antmicro/kintex-410t-devboard/assets/wireframe/wireframe_dimensions.png

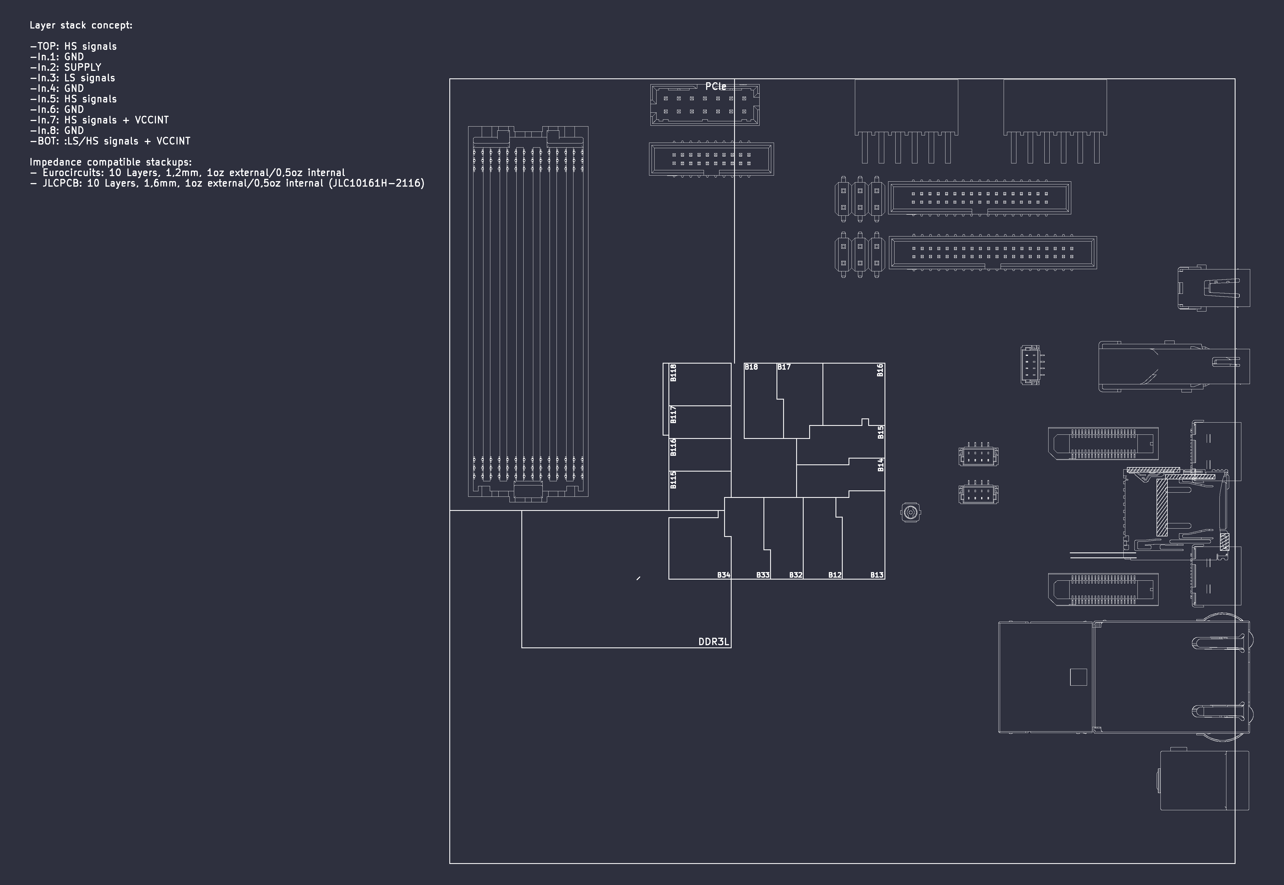
assets/wireframe/wireframe_dimensions.png
