antmicro/kintex-410t-devboard/assets/wireframe/wireframe_dimensions_bottom.png

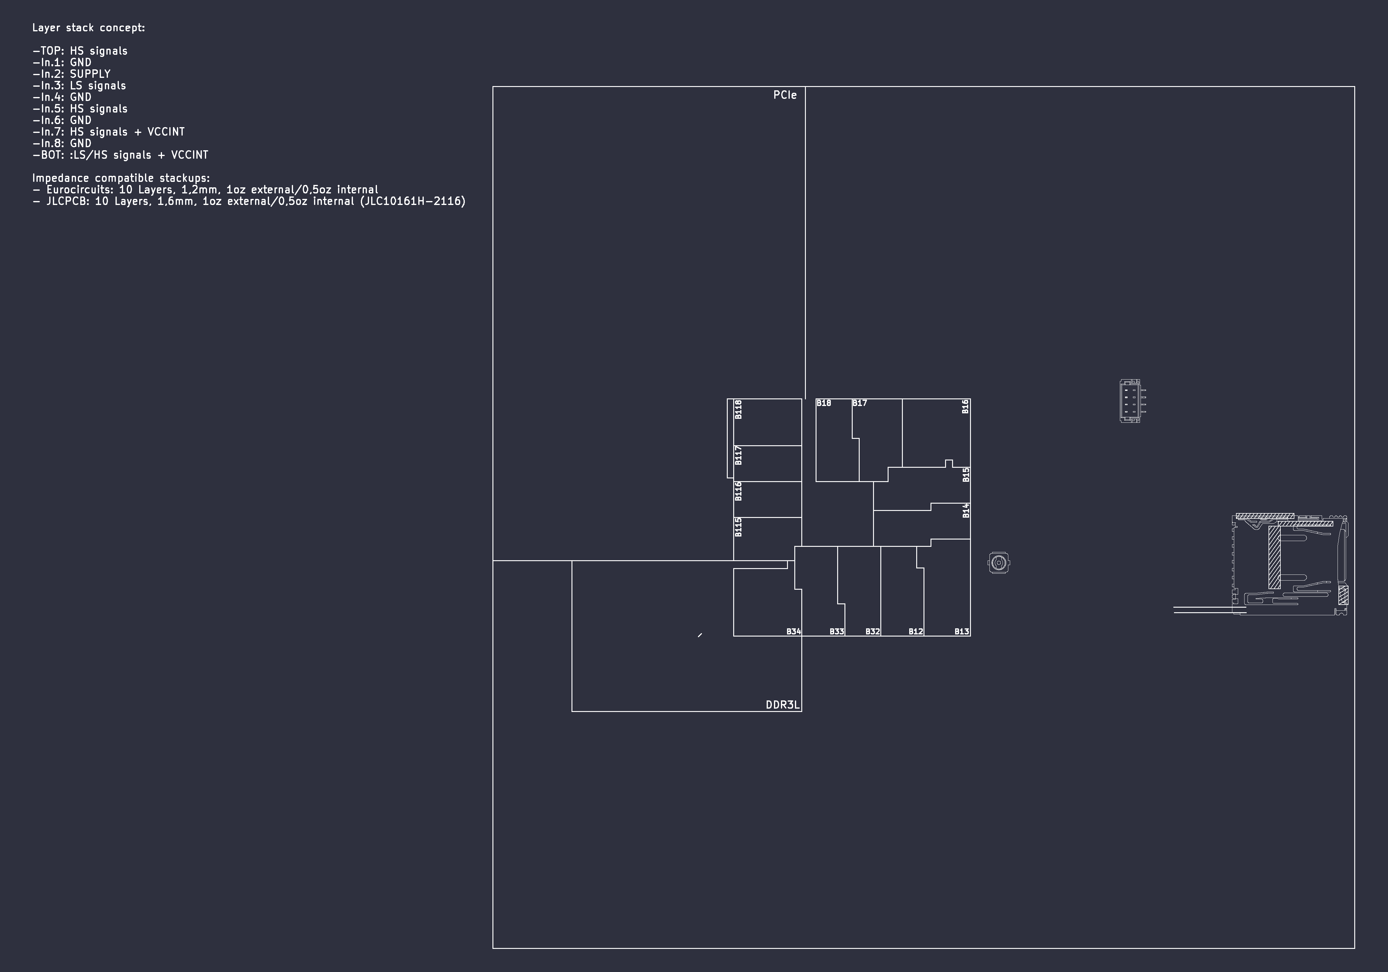
assets/wireframe/wireframe_dimensions_bottom.png
