antmicro/kintex-410t-devboard/assets/wireframe/wireframe_dimensions_top.png

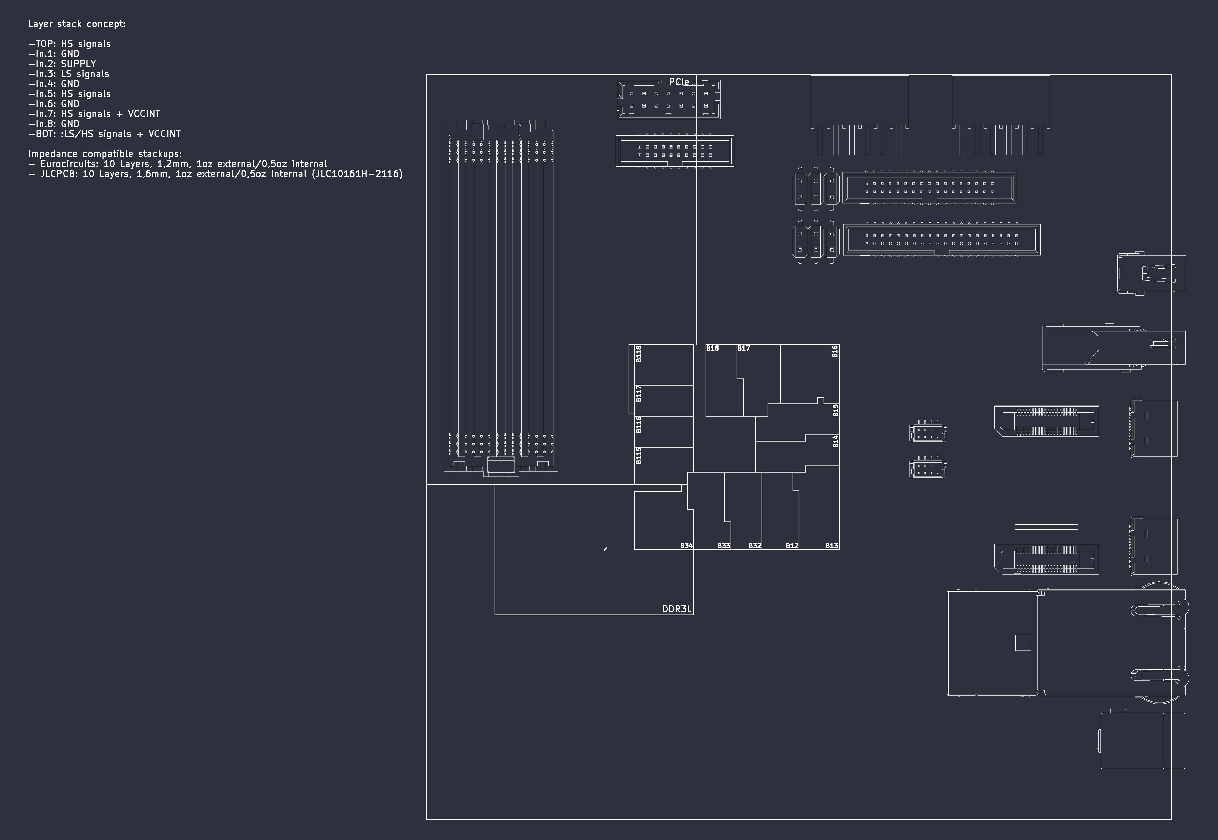
assets/wireframe/wireframe_dimensions_top.png
