antmicro/kintex-410t-devboard/(threads)

Thread 3 (2025-01-27):

Impedance question

ap-gval, 2025-01-27:
Good morning,

I have a question concerning the way the 100R impedance of HDMI is computed.

Example: pair HDMI_CONN_CLK_N, HDMI_CONN_CLK_P

Kicad project:  kintex-410t-devboard

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

coupled microstrip line

W = 0.153mm

S = 0.2mm

T = 0.035mm

H = 0.12mm

epsilon 3.9

I have got Z_odd = 60.8R so Z_diff = 2*Z_odd = 121.6R.

I have seen large differences between transmission line calculators I can't explain. Below calculations from calculators I think are correct.

QucsStudio (rename uSimmics)

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

Digikey

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

Could I have a feedback?

Thanks for your time. Maybe it will help improve your design on your side.

Guillaume

pkatarzynski, 2025-01-31:
Hi ap-gval

In your calculations on DigiKey website you input width of trace and height of dielectric as mils not mm.
If you change that unit to mm you'll see that it the outcome is 103 Ohm which matches the targed impedance (assuming +/-  5% margin)
We have cross-checked this with Saturn PCB Toolkit and the results are comparable.

We are not sure why uSimmics provides a different outcome. Is there a calculation formula documented for the uSimmcs? If so then it would be good to compare it with Digi-Key for instance (the Zd formula is visible in Digi-Key screenshot).

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

ap-gval, 2025-01-31:
Hello,

thank you for your answer. You right for my mistake.
At the moment I think the formula for coupled microstrip of Digikey, Saturn PCB (IPC 2141) is over simplified.
Kicad, Qucs, use one more complex (paper H. A. Atwater, “Simplified Design Equations for Microstrip Line Parameters”, can't find it again).

One remark for HDMI impedance can vary between 100R +/-15%.
I would like to check with a EM solver like openems, sonnet or freefem++.

Guillaume Valancogne

Closed 2025-01-31.
