antmicro/kintex-410t-devboard/K410T-devboard.kicad_pcb

## KiCad design K410T-devboard.kicad_pcb (2023-01-03)

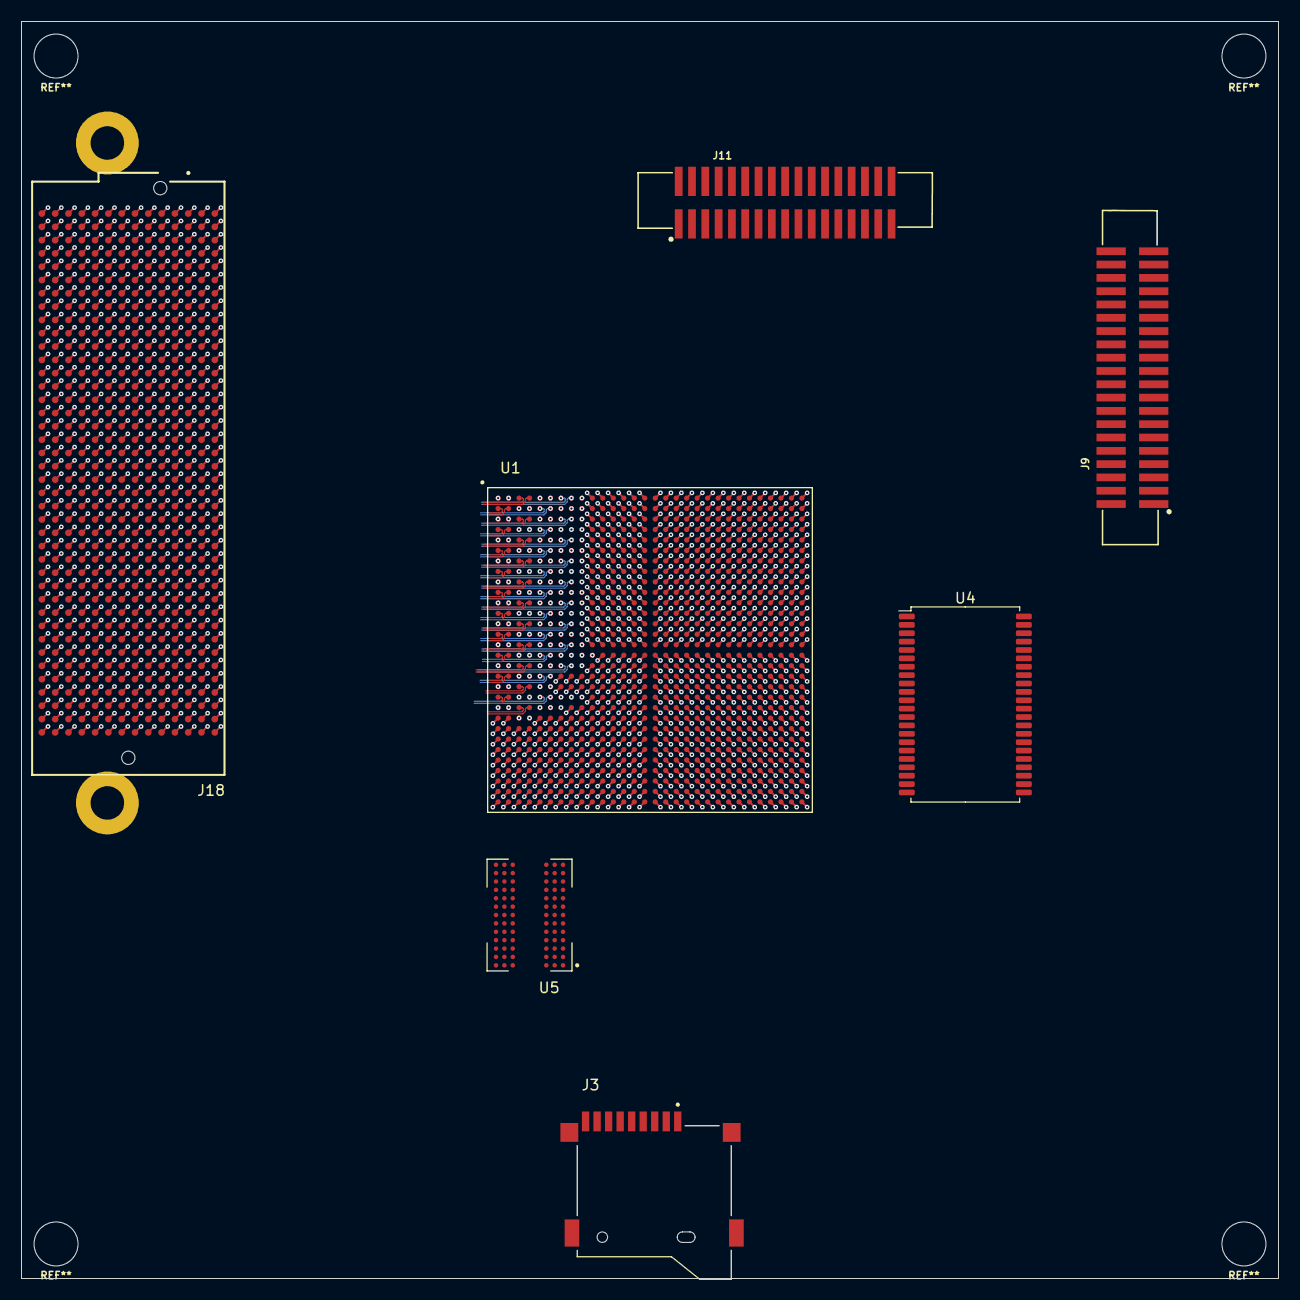
[picture p8: board K410T-devboard.kicad_pcb from above]

Board: 10 copper layers, 120.0 x 120.0 mm, 7 parts (0 on the bottom side), 213 nets.

Parts:
J3: 693071020811; WE_693071020811
J9: 62704020621; 627x4020621
J11: 62703420621; 627x3420621
J18: ASP-184329-01_mounting_holes_FMCPinout; ASP-184329-01_mounting_holes
U1: XC7K410T-2FFG900I; xc7k410t-2ffg900I
U4: AS6C8008-55ZIN; TSOP-II-44_10.16x18.41mm_P0.8mm
U5: MT41K512M8DA; Micron_FBGA-78

Connections:
3V3_SYS: J18.C39 (3P3V), J18.D36 (3P3V), J18.D38 (3P3V), J18.D40 (3P3V)
12P0V: J18.C35 (12P0V), J18.C37 (12P0V)
+0V675_VREF: U5.E1 (VREFDQ), U5.J8 (VREFCA)
+0V675_VTT: U1.AD7 (IO_L6N_T0_VREF_34), U1.AG8 (IO_L19N_T3_VREF_34)
+1V0: U1.M11 (VCCINT), U1.M13 (VCCINT), U1.M15 (VCCINT), U1.M17 (VCCINT), U1.N10 (VCCINT), U1.N12 (VCCINT), U1.N14 (VCCINT), U1.N16 (VCCBRAM), U1.N18 (VCCINT), U1.P11 (VCCINT), U1.P17 (VCCINT), U1.R10 (VCCINT), U1.R12 (VCCINT), U1.R16 (VCCBRAM), U1.R18 (VCCINT), U1.T11 (VCCINT), U1.T17 (VCCINT), U1.U10 (VCCINT), U1.U12 (VCCINT), U1.U16 (VCCBRAM), U1.U18 (VCCINT), U1.V17 (VCCINT), U1.W16 (VCCBRAM), U1.W18 (VCCINT)
+1V2_MGTAVCC: U1.B7 (MGTAVCC), U1.D7 (MGTAVCC), U1.F7 (MGTAVCC), U1.H7 (MGTAVCC), U1.K7 (MGTAVCC), U1.M7 (MGTAVCC), U1.P7 (MGTAVCC)
+1V2_MGTAVTT: U1.B3 (MGTAVTT), U1.C5 (MGTAVTT), U1.D3 (MGTAVTT), U1.E5 (MGTAVTT), U1.F3 (MGTAVTT), U1.G5 (MGTAVTT), U1.H3 (MGTAVTT), U1.J5 (MGTAVTT), U1.K3 (MGTAVTT), U1.L5 (MGTAVTT), U1.M3 (MGTAVTT), U1.N5 (MGTAVTT), U1.P3 (MGTAVTT), U1.R5 (MGTAVTT), U1.T3 (MGTAVTT), U1.U5 (MGTAVTT), U1.V3 (MGTAVTT), U1.W5 (MGTAVTT), U1.W7 (MGTAVTTRCAL_115)
+1V8: U1.AA9 (VCCO_33), U1.AA19 (VCCO_32), U1.AB16 (VCCO_32), U1.AC13 (VCCO_33), U1.AD10 (VCCO_33), U1.AE17 (VCCO_32), U1.AF14 (VCCO_32), U1.AG11 (VCCO_33), U1.AH18 (VCCO_32), U1.AJ15 (VCCO_32), U1.AK12 (VCCO_33), U1.P13 (VCCAUX), U1.T7 (MGTVCCAUX), U1.T13 (VCCAUX), U1.V7 (MGTVCCAUX), U1.V11 (VCCAUX_IO_G0), U1.V13 (VCCAUX), U1.V15 (VCCAUX), U1.W10 (VCCAUX_IO_G0), U1.W12 (VCCAUX_IO_G0), U1.W14 (VCCAUX), U1.Y12 (VCCO_33)
+1V35: U1.AC3 (VCCO_34), U1.AE7 (VCCO_34), U1.AF4 (VCCO_34), U1.AG1 (VCCO_34), U1.AH8 (VCCO_34), U1.AJ5 (VCCO_34), U1.AK2 (VCCO_34), U5.A2 (VDD), U5.A9 (VDD), U5.B9 (VDDQ), U5.C1 (VDDQ), U5.D7 (VDD), U5.E2 (VDDQ), U5.E9 (VDDQ), U5.G2 (VDD), U5.G8 (VDD), U5.K1 (VDD), U5.K9 (VDD), U5.M1 (VDD), U5.M9 (VDD)
+3V3: J3.4 (VDD), J9.22, J11.22, U1.AA29 (VCCO_13), U1.AB6 (VCCO_0), U1.AB26 (VCCO_13), U1.AC23 (VCCO_12), U1.AD20 (VCCO_12), U1.AD30 (VCCO_13), U1.AE27 (VCCO_13), U1.AF24 (VCCO_12), U1.AG21 (VCCO_12), U1.AH28 (VCCO_13), U1.AJ25 (VCCO_13), U1.AK22 (VCCO_12), U1.P30 (VCCO_14), U1.R27 (VCCO_14), U1.T9 (VCCO_0), U1.T24 (VCCO_14), U1.U21 (VCCO_14), U1.V28 (VCCO_14), U1.W25 (VCCO_14), U1.Y22 (VCCO_12), U4.11 (VCC), U4.33 (VCC)
/DRAM + SRAM/DDR.A0: U1.AE4 (IO_L10P_T1_34), U5.K3 (A0)
/DRAM + SRAM/DDR.A1: U1.AG3 (IO_L9N_T1_DQS_34), U5.L7 (A1)
/DRAM + SRAM/DDR.A2: U1.AG4 (IO_L9P_T1_DQS_34), U5.L3 (A2)
/DRAM + SRAM/DDR.A3: U1.AF1 (IO_L8N_T1_34), U5.K2 (A3)
/DRAM + SRAM/DDR.A4: U1.AE1 (IO_L8P_T1_34), U5.L8 (A4)
/DRAM + SRAM/DDR.A5: U1.AF2 (IO_L7N_T1_34), U5.L2 (A5)
/DRAM + SRAM/DDR.A6: U1.AF3 (IO_L7P_T1_34), U5.M8 (A6)
/DRAM + SRAM/DDR.A7: U1.AC7 (IO_L6P_T0_34), U5.M2 (A7)
/DRAM + SRAM/DDR.A8: U1.AE6 (IO_L5N_T0_34), U5.N8 (A8)
/DRAM + SRAM/DDR.A9: U1.AD6 (IO_L5P_T0_34), U5.M3 (A9)
/DRAM + SRAM/DDR.A10: U1.AC4 (IO_L4N_T0_34), U5.H7 (A10/AP)
/DRAM + SRAM/DDR.A11: U1.AC5 (IO_L4P_T0_34), U5.M7 (A11)
/DRAM + SRAM/DDR.A12: U1.AC1 (IO_L2N_T0_34), U5.K7 (A12/BC#)
/DRAM + SRAM/DDR.A13: U1.AC2 (IO_L2P_T0_34), U5.N3 (A13)
/DRAM + SRAM/DDR.A14: U1.AD3 (IO_L1N_T0_34), U5.N7 (A14)
/DRAM + SRAM/DDR.A15: U1.AD4 (IO_L1P_T0_34), U5.J7 (A15)
/DRAM + SRAM/DDR.BA0: U1.AF5 (IO_L11N_T1_SRCC_34), U5.J2 (BA0)
/DRAM + SRAM/DDR.BA1: U1.AE5 (IO_L11P_T1_SRCC_34), U5.K8 (BA1)
/DRAM + SRAM/DDR.BA2: U1.AE3 (IO_L10N_T1_34), U5.J3 (BA2)
/DRAM + SRAM/DDR.CKE: U1.AH2 (IO_L16P_T2_34), U5.G9 (CKE)
/DRAM + SRAM/DDR.CK_N: U1.AD1 (IO_L3N_T0_DQS_34), U5.G7 (CK#)
/DRAM + SRAM/DDR.CK_P: U1.AD2 (IO_L3P_T0_DQS_34), U5.F7 (CK)
/DRAM + SRAM/DDR.DM: U1.AF8 (IO_L19P_T3_34), U5.B7 (DM/TDQS)
/DRAM + SRAM/DDR.DQ0: U1.AK5 (IO_L24P_T3_34), U5.B3 (DQ0)
/DRAM + SRAM/DDR.DQ1: U1.AK8 (IO_L23N_T3_34), U5.C7 (DQ1)
/DRAM + SRAM/DDR.DQ2: U1.AK6 (IO_L22N_T3_34), U5.C2 (DQ2)
/DRAM + SRAM/DDR.DQ3: U1.AJ6 (IO_L22P_T3_34), U5.C8 (DQ3)
/DRAM + SRAM/DDR.DQ4: U1.AG7 (IO_L20N_T3_34), U5.E3 (NF/DQ4)
/DRAM + SRAM/DDR.DQ5: U1.AJ8 (IO_L23P_T3_34), U5.E8 (NF/DQ5)
/DRAM + SRAM/DDR.DQ6: U1.AK4 (IO_L24N_T3_34), U5.D2 (NF/DQ6)
/DRAM + SRAM/DDR.DQ7: U1.AF7 (IO_L20P_T3_34), U5.E7 (NF/DQ7)
/DRAM + SRAM/DDR.DQS_N: U1.AJ7 (IO_L21N_T3_DQS_34), U5.D3 (DQS#)
/DRAM + SRAM/DDR.DQS_P: U1.AH7 (IO_L21P_T3_DQS_34), U5.C3 (DQS)
/DRAM + SRAM/DDR.ODT: U1.AJ2 (IO_L16N_T2_34), U5.G1 (ODT)
/DRAM + SRAM/DDR.~CAS: U1.AF6 (IO_L12P_T1_MRCC_34), U5.G3 (CAS#)
/DRAM + SRAM/DDR.~CS: U1.AH1 (IO_L15N_T2_DQS_34), U5.H2 (CS#)
/DRAM + SRAM/DDR.~RAS: U1.AG5 (IO_L12N_T1_MRCC_34), U5.F3 (RAS#)
/DRAM + SRAM/DDR.~RESET: U1.AH4 (IO_L13P_T2_MRCC_34), U5.N2 (RESET#)
/DRAM + SRAM/DDR.~WE: U1.AG2 (IO_L15P_T2_DQS_34), U5.H3 (WE#)
/DRAM + SRAM/SRAM.A0: U1.U28 (IO_L13N_T2_MRCC_14), U4.5 (A0)
/DRAM + SRAM/SRAM.A1: U1.V29 (IO_L17P_T2_A14_D30_14), U4.4 (A1)
/DRAM + SRAM/SRAM.A2: U1.T25 (IO_L14P_T2_SRCC_14), U4.3 (A2)
/DRAM + SRAM/SRAM.A3: U1.T26 (IO_L12P_T1_MRCC_14), U4.2 (A3)
/DRAM + SRAM/SRAM.A4: U1.V20 (IO_L19N_T3_A09_D25_VREF_14), U4.1 (A4)
/DRAM + SRAM/SRAM.A5: U1.P27 (IO_L8P_T1_D11_14), U4.44 (A5)
/DRAM + SRAM/SRAM.A6: U1.P28 (IO_L8N_T1_D12_14), U4.43 (A6)
/DRAM + SRAM/SRAM.A7: U1.V24 (IO_L23N_T3_A02_D18_14), U4.42 (A7)
/DRAM + SRAM/SRAM.A8: U1.R26 (IO_L10N_T1_D15_14), U4.39 (A8)
/DRAM + SRAM/SRAM.A9: U1.R30 (IO_L9P_T1_DQS_14), U4.28 (A9)
/DRAM + SRAM/SRAM.A10: U1.U27 (IO_L13P_T2_MRCC_14), U4.27 (A10)
/DRAM + SRAM/SRAM.A11: U1.U25 (IO_L14N_T2_SRCC_14), U4.26 (A11)
/DRAM + SRAM/SRAM.A12: U1.V19 (IO_L19P_T3_A10_D26_14), U4.25 (A12)
/DRAM + SRAM/SRAM.A13: U1.T27 (IO_L12N_T1_MRCC_14), U4.24 (A13)
/DRAM + SRAM/SRAM.A14: U1.U23 (IO_L21N_T3_DQS_A06_D22_14), U4.23 (A14)
/DRAM + SRAM/SRAM.A15: U1.T30 (IO_L9N_T1_DQS_D13_14), U4.22 (A15)
/DRAM + SRAM/SRAM.A16: U1.W23 (IO_L20P_T3_A08_D24_14), U4.21 (A16)
/DRAM + SRAM/SRAM.A17: U1.W24 (IO_L20N_T3_A07_D23_14), U4.20 (A17)
/DRAM + SRAM/SRAM.A18: U1.V25 (IO_L18P_T2_A12_D28_14), U4.19 (A18)
/DRAM + SRAM/SRAM.A19: U1.W26 (IO_L18N_T2_A11_D27_14), U4.18 (A19)
/DRAM + SRAM/SRAM.CE2: U1.U22 (IO_L21P_T3_DQS_14), U4.40 (CE2)
/DRAM + SRAM/SRAM.DQ0: U1.V21 (IO_L22P_T3_A05_D21_14), U4.9 (DQ0)
/DRAM + SRAM/SRAM.DQ1: U1.V30 (IO_L17N_T2_A13_D29_14), U4.10 (DQ1)
/DRAM + SRAM/SRAM.DQ2: U1.W21 (IO_L24P_T3_A01_D17_14), U4.13 (DQ2)
/DRAM + SRAM/SRAM.DQ3: U1.P29 (IO_L7P_T1_D09_14), U4.14 (DQ3)
/DRAM + SRAM/SRAM.DQ4: U1.U20 (IO_L6N_T0_D08_VREF_14), U4.31 (DQ4)
/DRAM + SRAM/SRAM.DQ5: U1.T28 (IO_L11N_T1_SRCC_14), U4.32 (DQ5)
/DRAM + SRAM/SRAM.DQ6: U1.R28 (IO_L11P_T1_SRCC_14), U4.35 (DQ6)
/DRAM + SRAM/SRAM.DQ7: U1.R29 (IO_L7N_T1_D10_14), U4.36 (DQ7)
/DRAM + SRAM/SRAM.~CE: U1.V27 (IO_L16N_T2_A15_D31_14), U4.6 (CE#)
/DRAM + SRAM/SRAM.~OE: U1.P26 (IO_L10P_T1_D14_14), U4.41 (OE#)
/DRAM + SRAM/SRAM.~WE: U1.W22 (IO_L24N_T3_A00_D16_14), U4.17 (WE#)
/FMC+ HSPC/FMC.IO0: J18.G33 (LA31_P), U1.G12 (IO0_18)
/FMC+ HSPC/FMC.IO1_N: J18.G22 (LA20_N), U1.K16 (IOL1N_T0_18)
/FMC+ HSPC/FMC.IO1_P: J18.G21 (LA20_P), U1.L16 (IOL1P_T0_18)
/FMC+ HSPC/FMC.IO2_N: J18.G19 (LA16_N), U1.K15 (IOL2N_T0_18)
/FMC+ HSPC/FMC.IO2_P: J18.G18 (LA16_P), U1.L15 (IOL2P_T0_18)
/FMC+ HSPC/FMC.IO3_N: J18.H20 (LA15_N), U1.L13 (IOL3N_T0_DQS_18)
/FMC+ HSPC/FMC.IO3_P: J18.H19 (LA15_P), U1.L12 (IOL3P_T0_DQS_18)
/FMC+ HSPC/FMC.IO4_N: J18.H17 (LA11_N), U1.J13 (IOL4N_T0_18)
/FMC+ HSPC/FMC.IO4_P: J18.H16 (LA11_P), U1.K13 (IOL4P_T0_18)
/FMC+ HSPC/FMC.IO5_N: J18.J19 (HA18_N), U1.J14 (IOL5N_T0_18)
/FMC+ HSPC/FMC.IO5_P: J18.J18 (HA18_P), U1.K14 (IOL5P_T0_18)
/FMC+ HSPC/FMC.IO6_N: J18.G25 (LA22_N), U1.K11 (IOL6N_T0_VREF_18)
/FMC+ HSPC/FMC.IO6_P: J18.G24 (LA22_P), U1.L11 (IOL6P_T0_18)
/FMC+ HSPC/FMC.IO7_N: J18.H29 (LA24_N), U1.G15 (IOL7N_T1_18)
/FMC+ HSPC/FMC.IO7_P: J18.H28 (LA24_P), U1.H15 (IOL7P_T1_18)
/FMC+ HSPC/FMC.IO8_N: J18.G28 (LA25_N), U1.J12 (IOL8N_T1_18)
/FMC+ HSPC/FMC.IO8_P: J18.G27 (LA25_P), U1.J11 (IOL8P_T1_18)
/FMC+ HSPC/FMC.IO9_N: J18.G31 (LA29_N), U1.H16 (IOL9N_T1_DQS_18)
/FMC+ HSPC/FMC.IO9_P: J18.G30 (LA29_P), U1.J16 (IOL9P_T1_DQS_18)
/FMC+ HSPC/FMC.IO10_N: J18.H26 (LA21_N), U1.H12 (IOL10N_T1_18)
/FMC+ HSPC/FMC.IO10_P: J18.H25 (LA21_P), U1.H11 (IOL10P_T1_18)
/FMC+ HSPC/FMC.IO11_N: J18.K23 (HA23_N), U1.G14 (IOL11N_T1_SRCC_18)
/FMC+ HSPC/FMC.IO11_P: J18.K22 (HA23_P), U1.H14 (IOL11P_T1_SRCC_18)
/FMC+ HSPC/FMC.IO12_N: J18.J22 (HA22_N), U1.F13 (IOL12N_T1_MRCC_18)
/FMC+ HSPC/FMC.IO12_P: J18.J21 (HA22_P), U1.G13 (IOL12P_T1_MRCC_18)
/FMC+ HSPC/FMC.IO13_N: J18.K20 (HA21_N), U1.D13 (IOL13N_T2_MRCC_18)
/FMC+ HSPC/FMC.IO13_P: J18.K19 (HA21_P), U1.D12 (IOL13P_T2_MRCC_18)
/FMC+ HSPC/FMC.IO14_N: J18.J25 (HB01_N), U1.E13 (IOL14N_T2_SRCC_18)
/FMC+ HSPC/FMC.IO14_P: J18.J24 (HB01_P), U1.F12 (IOL14P_T2_SRCC_18)
/FMC+ HSPC/FMC.IO16_N: J18.K08 (HA02_N), U1.E11 (IOL16N_T2_18)
/FMC+ HSPC/FMC.IO16_P: J18.K07 (HA02_P), U1.F11 (IOL16P_T2_18)
/FMC+ HSPC/FMC.IO17_N: J18.K17 (HA17_N_CC), U1.A12 (IOL17N_T2_18)
/FMC+ HSPC/FMC.IO17_P: J18.K16 (HA17_P_CC), U1.A11 (IOL17P_T2_18)
/FMC+ HSPC/FMC.IO18_N: J18.J10 (HA07_N), U1.C11 (IOL18N_T2_18)
/FMC+ HSPC/FMC.IO18_P: J18.J09 (HA07_P), U1.D11 (IOL18P_T2_18)
/FMC+ HSPC/FMC.IO19_N: J18.H23 (LA19_N), U1.E16 (IOL19N_T3_VREF_18)
/FMC+ HSPC/FMC.IO19_P: J18.H22 (LA19_P), U1.F15 (IOL19P_T3_18)
/FMC+ HSPC/FMC.IO20_N: J18.K26 (HB00_N_CC), U1.E15 (IOL20N_T3_18)
/FMC+ HSPC/FMC.IO20_P: J18.K25 (HB00_P_CC), U1.E14 (IOL20P_T3_18)
/FMC+ HSPC/FMC.IO21_N: J18.K11 (HA06_N), U1.C14 (IOL21N_T3_DQS_18)
/FMC+ HSPC/FMC.IO21_P: J18.K10 (HA06_P), U1.D14 (IOL21P_T3_DQS_18)
/FMC+ HSPC/FMC.IO23_N: J18.J13 (HA11_N), U1.B15 (IOL23N_T3_18)
/FMC+ HSPC/FMC.IO23_P: J18.J12 (HA11_P), U1.C15 (IOL23P_T3_18)
/FMC+ HSPC/FMC.IO24_N: J18.J28 (HB07_N), U1.A15 (IOL24N_T3_18)
/FMC+ HSPC/FMC.IO24_P: J18.J27 (HB07_P), U1.B14 (IOL24P_T3_18)
/FMC+ HSPC/FMC.IO25: J18.K28 (HB06_P_CC), U1.F16 (IO25_18)
/FMC+ HSPC/GTX115.RX0_N: J18.B13 (DP7_M2C_N), U1.AA3 (MGTXRXN0_115)
/FMC+ HSPC/GTX115.RX0_P: J18.B12 (DP7_M2C_P), U1.AA4 (MGTXRXP0_115)
/FMC+ HSPC/GTX115.RX1_N: J18.B17 (DP6_M2C_N), U1.Y5 (MGTXRXN1_115)
/FMC+ HSPC/GTX115.RX1_P: J18.B16 (DP6_M2C_P), U1.Y6 (MGTXRXP1_115)
/FMC+ HSPC/GTX115.RX2_N: J18.A19 (DP5_M2C_N), U1.W3 (MGTXRXN2_115)
/FMC+ HSPC/GTX115.RX2_P: J18.A18 (DP5_M2C_P), U1.W4 (MGTXRXP2_115)
/FMC+ HSPC/GTX115.RX3_N: J18.A15 (DP4_M2C_N), U1.V5 (MGTXRXN3_115)
/FMC+ HSPC/GTX115.RX3_P: J18.A14 (DP4_M2C_P), U1.V6 (MGTXRXP3_115)
/FMC+ HSPC/GTX116.RX0_N: J18.A11 (DP3_M2C_N), U1.T5 (MGTXRXN0_116)
/FMC+ HSPC/GTX116.RX0_P: J18.A10 (DP3_M2C_P), U1.T6 (MGTXRXP0_116)
/FMC+ HSPC/GTX116.RX1_N: J18.A07 (DP2_M2C_N), U1.R3 (MGTXRXN1_116)
/FMC+ HSPC/GTX116.RX1_P: J18.A06 (DP2_M2C_P), U1.R4 (MGTXRXP1_116)
/FMC+ HSPC/GTX116.RX2_N: J18.A03 (DP1_M2C_N), U1.P5 (MGTXRXN2_116)
/FMC+ HSPC/GTX116.RX2_P: J18.A02 (DP1_M2C_P), U1.P6 (MGTXRXP2_116)
/FMC+ HSPC/GTX116.RX3_N: J18.C07 (DP0_M2C_N), U1.M5 (MGTXRXN3_116)
/FMC+ HSPC/GTX116.RX3_P: J18.C06 (DP0_M2C_P), U1.M6 (MGTXRXP3_116)
/FPGA Bank 33/SD_CARD.CLK: J3.5 (CLK), U1.AC11 (IO_L9N_T1_DQS_33)
/FPGA Bank 33/SD_CARD.CMD: J3.3 (CMD), U1.AC10 (IO_L7N_T1_33)
/FPGA Bank 33/SD_CARD.DAT0: J3.7 (DAT0), U1.AK14 (IO_L20P_T3_33)
/FPGA Bank 33/SD_CARD.DAT1: J3.8 (DAT1), U1.AF11 (IO_L11N_T1_SRCC_33)
/FPGA Bank 33/SD_CARD.DAT2: J3.1 (DAT2), U1.AE9 (IO_L10N_T1_33)
/FPGA Bank 33/SD_CARD.DAT3: J3.2 (DAT3/CD), U1.AB10 (IO_L7P_T1_33)
/USER_IO.A1: J9.1, U1.M19 (IO_0_15)
/USER_IO.A3: J9.3, U1.L30 (IO_L9P_T1_DQS_AD11P_15)
/USER_IO.A5: J9.5, U1.P21 (IO_L22P_T3_A17_15)
/USER_IO.A7: J9.7, U1.N20 (IO_L19N_T3_A21_VREF_15)
/USER_IO.A9: J9.9, U1.J29 (IO_L7P_T1_AD10P_15)
/USER_IO.A11: J9.11, U1.M28 (IO_L14P_T2_SRCC_15)
/USER_IO.A12: J9.12, U1.J27 (IO_L8P_T1_AD3P_15)
/USER_IO.A13: J9.13, U1.H29 (IO_L7N_T1_AD10N_15)
/USER_IO.A14: J9.14, U1.J28 (IO_L8N_T1_AD3N_15)
/USER_IO.A15: J9.15, U1.N19 (IO_L19P_T3_A22_15)
/USER_IO.A16: J9.16, U1.M20 (IO_L6P_T0_15)
/USER_IO.A17: J9.17, U1.J26 (IO_L10N_T1_AD4N_15)
/USER_IO.A18: J9.18, U1.L20 (IO_L6N_T0_VREF_15)
/USER_IO.A21: J9.21, U1.M27 (IO_L16N_T2_A27_15)
/USER_IO.A23: J9.23, U1.M29 (IO_L15P_T2_DQS_15)
/USER_IO.A24: J9.24, U1.N30 (IO_L17N_T2_A25_15)
/USER_IO.A25: J9.25, U1.L21 (IO_L4P_T0_AD9P_15)
/USER_IO.A26: J9.26, U1.J22 (IO_L5N_T0_AD2N_15)
/USER_IO.A27: J9.27, U1.P22 (IO_L22N_T3_A16_15)
/USER_IO.A28: J9.28, U1.M30 (IO_L15N_T2_DQS_ADV_B_15)
/USER_IO.A29: J9.29, U1.M23 (IO_L24N_T3_RS0_15)
/USER_IO.A30: J9.30, U1.N27 (IO_L16P_T2_A28_15)
/USER_IO.A31: J9.31, U1.L26 (IO_L11P_T1_SRCC_AD12P_15)
/USER_IO.A32: J9.32, U1.K28 (IO_L13P_T2_MRCC_15)
/USER_IO.A33: J9.33, U1.L28 (IO_L14N_T2_SRCC_15)
/USER_IO.A35: J9.35, U1.L25 (IO_L12P_T1_MRCC_AD5P_15)
/USER_IO.A36: J9.36, U1.N29 (IO_L17P_T2_A26_15)
/USER_IO.A37: J9.37, U1.L27 (IO_L11N_T1_SRCC_AD12N_15)
/USER_IO.A38: J9.38, U1.N26 (IO_L18N_T2_A23_15)
/USER_IO.A39: J9.39, U1.K26 (IO_L10P_T1_AD4P_15)
/USER_IO.A40: J9.40, U1.K21 (IO_L4N_T0_AD9N_15)
/USER_IO.B1: J11.1, U1.D27 (IO_L13P_T2_MRCC_16)
/USER_IO.B3: J11.3, U1.A30 (IO_L17N_T2_16)
/USER_IO.B5: J11.5, U1.H25 (IO_L19N_T3_VREF_16)
/USER_IO.B6: J11.6, U1.C26 (IO_L11N_T1_SRCC_16)
/USER_IO.B7: J11.7, U1.E29 (IO_L18P_T2_16)
/USER_IO.B8: J11.8, U1.A23 (IO_L1N_T0_16)
/USER_IO.B9: J11.9, U1.A28 (IO_L9N_T1_DQS_16)
/USER_IO.B10: J11.10, U1.A27 (IO_L7N_T1_16)
/USER_IO.B11: J11.11, U1.A26 (IO_L10N_T1_16)
/USER_IO.B12: J11.12, U1.B27 (IO_L7P_T1_16)
/USER_IO.B14: J11.14, U1.C25 (IO_L12P_T1_MRCC_16)
/USER_IO.B15: J11.15, U1.B28 (IO_L9P_T1_DQS_16)
/USER_IO.B16: J11.16, U1.B24 (IO_L8N_T1_16)
/USER_IO.B17: J11.17, U1.G29 (IO_L22P_T3_16)
/USER_IO.B18: J11.18, U1.C24 (IO_L8P_T1_16)
/USER_IO.B19: J11.19, U1.F30 (IO_L22N_T3_16)
/USER_IO.B21: J11.21, U1.F28 (IO_L20N_T3_16)
/USER_IO.B23: J11.23, U1.G28 (IO_L20P_T3_16)
/USER_IO.B24: J11.24, U1.A25 (IO_L10P_T1_16)
/USER_IO.B25: J11.25, U1.G30 (IO_L24N_T3_16)
/USER_IO.B26: J11.26, U1.B25 (IO_L12N_T1_MRCC_16)
/USER_IO.B27: J11.27, U1.H30 (IO_L24P_T3_16)
/USER_IO.B28: J11.28, U1.E30 (IO_L18N_T2_16)
/USER_IO.B29: J11.29, U1.H24 (IO_L19P_T3_16)
/USER_IO.B30: J11.30, U1.C27 (IO_L13N_T2_MRCC_16)
/USER_IO.B31: J11.31, U1.F27 (IO_L21N_T3_DQS_16)
/USER_IO.B33: J11.33, U1.G27 (IO_L21P_T3_DQS_16)
EP: J3.6 (VSS), J9.2, J9.4, J9.6, J9.8, J9.10, J9.20, J9.34, J11.2, J11.4, J11.20, J18.A01 (GND), J18.A04 (GND), J18.A05 (GND), J18.A08 (GND), J18.A09 (GND), J18.A12 (GND), J18.A13 (GND), J18.A16 (GND), J18.A17 (GND), J18.A20 (GND), J18.A21 (GND), J18.A24 (GND), J18.A25 (GND), J18.A28 (GND), J18.A29 (GND), J18.A32 (GND), J18.A33 (GND), J18.A36 (GND), J18.A37 (GND), J18.A40 (GND), J18.B02 (GND), J18.B03 (GND), J18.B06 (GND), J18.B07 (GND), J18.B10 (GND), J18.B11 (GND), J18.B14 (GND), J18.B15 (GND), J18.B18 (GND), J18.B19 (GND), J18.B22 (GND), J18.B23 (GND), J18.B26 (GND), J18.B27 (GND), J18.B30 (GND), J18.B31 (GND), J18.B34 (GND), J18.B35 (GND), J18.B38 (GND), J18.B39 (GND), J18.C01 (GND), J18.C04 (GND), J18.C05 (GND), J18.C08 (GND), J18.C09 (GND), J18.C12 (GND), J18.C13 (GND), J18.C16 (GND), J18.C17 (GND), J18.C20 (GND), J18.C21 (GND), J18.C24 (GND), J18.C25 (GND), J18.C28 (GND), J18.C29 (GND), J18.C32 (GND), J18.C33 (GND), J18.C36 (GND), J18.C38 (GND), J18.C40 (GND), J18.D02 (GND), J18.D03 (GND), J18.D06 (GND), J18.D07 (GND), J18.D10 (GND), J18.D13 (GND), J18.D16 (GND), J18.D19 (GND), J18.D22 (GND), J18.D25 (GND), J18.D28 (GND), J18.D37 (GND), J18.D39 (GND), J18.E01 (GND), J18.E04 (GND), J18.E05 (GND), J18.E08 (GND), J18.E11 (GND), J18.E14 (GND), J18.E17 (GND), J18.E20 (GND), J18.E23 (GND), J18.E26 (GND), J18.E29 (GND), J18.E32 (GND), J18.E35 (GND), J18.E38 (GND), J18.E40 (GND), J18.F02 (GND), J18.F03 (GND), J18.F06 (GND), J18.F09 (GND), J18.F12 (GND), J18.F15 (GND), J18.F18 (GND), J18.F21 (GND), J18.F24 (GND), J18.F27 (GND), J18.F30 (GND), J18.F33 (GND), J18.F36 (GND), J18.F39 (GND), J18.G01 (GND), J18.G04 (GND), J18.G05 (GND), J18.G08 (GND), J18.G11 (GND), J18.G14 (GND), J18.G17 (GND), J18.G20 (GND), J18.G23 (GND), J18.G26 (GND), J18.G29 (GND), J18.G32 (GND), J18.G35 (GND), J18.G38 (GND), J18.G40 (GND), J18.H03 (GND), J18.H06 (GND), J18.H09 (GND), J18.H12 (GND), J18.H15 (GND), J18.H18 (GND), J18.H21 (GND), J18.H24 (GND), J18.H27 (GND), J18.H30 (GND), J18.H33 (GND), J18.H36 (GND), J18.H39 (GND), J18.J01 (GND), J18.J04 (GND), J18.J05 (GND), J18.J08 (GND), J18.J11 (GND), J18.J14 (GND), J18.J17 (GND), J18.J20 (GND), J18.J23 (GND), J18.J26 (GND), J18.J29 (GND), J18.J32 (GND), J18.J35 (GND), J18.J38 (GND), J18.J40 (GND), J18.K02 (GND), J18.K03 (GND), J18.K06 (GND), J18.K09 (GND), J18.K12 (GND), J18.K15 (GND), J18.K18 (GND), J18.K21 (GND), J18.K24 (GND), J18.K27 (GND), J18.K30 (GND), J18.K33 (GND), J18.K36 (GND), J18.K39 (GND), U1.A1 (GND), U1.A2 (GND), U1.A5 (GND), U1.A6 (GND), U1.A9 (GND), U1.A14 (GND), U1.A24 (GND), U1.AA1 (GND), U1.AA2 (GND), U1.AA5 (GND), U1.AA6 (GND), U1.AA7 (GND), U1.AA14 (GND), U1.AA24 (GND), U1.AB3 (GND), U1.AB4 (GND), U1.AB11 (GND), U1.AB21 (GND), U1.AC8 (GND), U1.AC18 (GND), U1.AC28 (GND), U1.AD5 (GND), U1.AD15 (GND), U1.AD25 (GND), U1.AE2 (GND), U1.AE12 (GND), U1.AE22 (GND), U1.AF9 (GND), U1.AF19 (GND), U1.AF29 (GND), U1.AG6 (GND), U1.AG16 (GND), U1.AG26 (GND), U1.AH3 (GND), U1.AH13 (GND), U1.AH23 (GND), U1.AJ10 (GND), U1.AJ20 (GND), U1.AJ30 (GND), U1.AK7 (GND), U1.AK17 (GND), U1.AK27 (GND), U1.B4 (GND), U1.B8 (GND), U1.B9 (GND), U1.B11 (GND), U1.B21 (GND), U1.C1 (GND), U1.C2 (GND), U1.C6 (GND), U1.C9 (GND), U1.C18 (GND), U1.C28 (GND), U1.D4 (GND), U1.D8 (GND), U1.D9 (GND), U1.D15 (GND), U1.D25 (GND), U1.E1 (GND), U1.E2 (GND), U1.E6 (GND), U1.E9 (GND), U1.E12 (GND), U1.E22 (GND), U1.F4 (GND), U1.F8 (GND), U1.F9 (GND), U1.F19 (GND), U1.F29 (GND), U1.G1 (GND), U1.G2 (GND), U1.G6 (GND), U1.G9 (GND), U1.G16 (GND), U1.G26 (GND), U1.H4 (GND), U1.H8 (GND), U1.H9 (GND), U1.H13 (GND), U1.H23 (GND), U1.J1 (GND), U1.J2 (GND), U1.J6 (GND), U1.J9 (GND), U1.J10 (GND), U1.J20 (GND), U1.J30 (GND), U1.K4 (GND), U1.K8 (GND), U1.K9 (GND), U1.K17 (GND), U1.K27 (GND), U1.L1 (GND), U1.L2 (GND), U1.L6 (GND), U1.L9 (GND), U1.L14 (GND), U1.L24 (GND), U1.M4 (GND), U1.M8 (GND), U1.M9 (GND), U1.M12 (GND), U1.M14 (GND), U1.M16 (GND), U1.M18 (GND), U1.M21 (GND), U1.N1 (GND), U1.N2 (GND), U1.N6 (GND), U1.N9 (GND), U1.N11 (GND), U1.N13 (GND), U1.N15 (GND), U1.N17 (GND), U1.N28 (GND), U1.P4 (GND), U1.P8 (GND), U1.P9 (GND), U1.P10 (GND), U1.P12 (GND), U1.P14 (GNDADC_0), U1.P16 (GND), U1.P18 (GND), U1.P25 (GND), U1.R1 (GND), U1.R2 (GND), U1.R6 (GND), U1.R9 (GND), U1.R11 (GND), U1.R13 (GND), U1.R14 (VREFN_0), U1.R17 (GND), U1.R22 (GND), U1.T4 (GND), U1.T8 (GND), U1.T10 (GND), U1.T12 (GND), U1.T16 (GND), U1.T18 (GND), U1.T19 (GND), U1.T29 (GND), U1.U1 (GND), U1.U2 (GND), U1.U6 (GND), U1.U9 (GND), U1.U11 (GND), U1.U13 (GND), U1.U17 (GND), U1.U26 (GND), U1.V4 (GND), U1.V8 (GND), U1.V9 (GND), U1.V10 (GND), U1.V12 (GND), U1.V14 (GND), U1.V16 (GND), U1.V18 (GND), U1.V23 (GND), U1.W1 (GND), U1.W2 (GND), U1.W6 (GND), U1.W9 (GND), U1.W11 (GND), U1.W13 (GND), U1.W15 (GND), U1.W17 (GND), U1.W20 (GND), U1.W30 (GND), U1.Y3 (GND), U1.Y4 (GND), U1.Y7 (GND), U1.Y8 (GND), U1.Y9 (GND), U1.Y17 (GND), U1.Y27 (GND), U4.12 (VSS), U4.34 (VSS), U5.A1 (VSS), U5.A8 (VSS), U5.B1 (VSS), U5.B2 (VSSQ), U5.B8 (VSSQ), U5.C9 (VSSQ), U5.D1 (VSSQ), U5.D8 (VSS), U5.D9 (VSSQ), U5.F2 (VSS), U5.F8 (VSS), U5.J1 (VSS), U5.J9 (VSS), U5.L1 (VSS), U5.L9 (VSS), U5.N1 (VSS), U5.N9 (VSS)
unnamed: J3.10 (GND), J3.11 (GND), J3.12 (GND), J3.13 (GND)
VCCO_15: U1.J25 (VCCO_15), U1.K22 (VCCO_15), U1.L29 (VCCO_15), U1.M26 (VCCO_15), U1.N23 (VCCO_15), U1.P20 (VCCO_15)
VCCO_16: U1.A29 (VCCO_16), U1.B26 (VCCO_16), U1.C23 (VCCO_16), U1.D30 (VCCO_16), U1.E27 (VCCO_16), U1.F24 (VCCO_16), U1.H28 (VCCO_16)
VCCO_17: U1.A19 (VCCO_17), U1.B16 (VCCO_17), U1.D20 (VCCO_17), U1.E17 (VCCO_17), U1.G21 (VCCO_17), U1.H18 (VCCO_17), U1.L19 (VCCO_17)
VCCO_18: U1.C13 (VCCO_18), U1.D10 (VCCO_18), U1.F14 (VCCO_18), U1.G11 (VCCO_18), U1.J15 (VCCO_18), U1.K12 (VCCO_18)
