antmicro/kintex-410t-devboard/(commit log)

2022-12-19 Initial commit. Create KiCad project, add .gitignore and LICENSE
    [K410T-devboard.kicad_pcb, K410T-devboard.kicad_sch]
2022-12-19 Import EC 8C DRC rule template
    [K410T-devboard.kicad_pcb]
2022-12-19 Add XC7K410T-2FFG900 symbol, create hierarchical sheet structure
    [FPGA_Config.kicad_sch, FPGA_MGT.kicad_sch, FPGA_banks_12-15.kicad_sch, FPGA_banks_16-32.kicad_sch, FPGA_banks_33-34.kicad_sch, FPGA_power.kicad_sch, FPGA_supply.kicad_sch, K410T-devboard.kicad_sch]
2022-12-19 Add mandatory decoupling
    [FPGA_supply.kicad_sch, K410T-devboard.kicad_sch]
2022-12-19 Create nano-ITX board edge, create\ FPGA quadrant-style fanout
    [K410T-devboard.kicad_pcb]
2022-12-19 Add MT41K512M8DA DDR3L
    [DDR3L_SDRAM.kicad_sch, FPGA_Config.kicad_sch, FPGA_MGT.kicad_sch, FPGA_banks_12-15.kicad_sch, FPGA_banks_16-32.kicad_sch, FPGA_banks_33-34.kicad_sch, FPGA_supply.kicad_sch, K410T-devboard.kicad_pcb]
2022-12-20 Define DDR3 bus
    [K410T-devboard.kicad_sch]
2022-12-20 Add DDR3L nets, termination and decoupling
    [DDR3L_SDRAM.kicad_sch]
2022-12-20 Connect DDR3L to FPGA
    [DDR3L_SDRAM.kicad_sch, FPGA_banks_33-34.kicad_sch]
2022-12-20 Add SRAM, reorganize SDRAM sheet
    [DDR3L_SDRAM.kicad_sch]
2022-12-20 Add SRAM signals to FPGA banks 12-15 sheet
    [FPGA_banks_12-15.kicad_sch]
2022-12-20 Add SRAM bus definition, add RESET to DDR3 bus
    [K410T-devboard.kicad_sch]
2022-12-20 Connect SRAM to FPGA
    [FPGA_banks_12-15.kicad_sch]
2022-12-20 Reorder SRAM singal connections to FPGA
    [FPGA_banks_12-15.kicad_sch]
2022-12-20 Unify title block
    [DDR3L_SDRAM.kicad_sch, FPGA_Config.kicad_sch, FPGA_MGT.kicad_sch, FPGA_banks_12-15.kicad_sch, FPGA_banks_16-32.kicad_sch, FPGA_banks_33-34.kicad_sch, FPGA_supply.kicad_sch, K410T-devboard.kicad_pcb]
2022-12-21 Update project files naming, reorganize hierarchical sheet structure, power supply WIP
    [K410T-devboard.kicad_pcb, K410T-devboard.kicad_sch, fpga-banks-12-15.kicad_sch, fpga-banks-16-32.kicad_sch, fpga-banks-33-34.kicad_sch, fpga-config.kicad_sch, fpga-mgt.kicad_sch, fpga-supply.kicad_sch]
2022-12-21 FPGA power supply WIP
    [K410T-devboard.kicad_sch, power-supply.kicad_sch]
2022-12-21 Remove old schematic files
    [DDR3L_SDRAM.kicad_sch, FPGA_Config.kicad_sch, FPGA_MGT.kicad_sch, FPGA_banks_12-15.kicad_sch, FPGA_banks_16-32.kicad_sch, FPGA_banks_33-34.kicad_sch, FPGA_power.kicad_sch, FPGA_supply.kicad_sch]
2022-12-21 Add SPI-FLASH bus and SPI Flash IC. Connet it to FPGA
    [K410T-devboard.kicad_sch, fpga-banks-12-15.kicad_sch, fpga-config.kicad_sch, spi-flash.kicad_sch]
2022-12-21 Add config mode slide switch
    [K410T-devboard.kicad_sch, fpga-config.kicad_sch]
2022-12-21 Add JTAG bus. Add labels to FPGA JTAG pins
    [K410T-devboard.kicad_sch, fpga-config.kicad_sch]
2022-12-21 Add done, init leds and program_b button
    [K410T-devboard.kicad_sch, fpga-config.kicad_sch]
2022-12-22 Add FPGA planar decoupling, finish DC-DC for 1V2, 1V35, 1V8, 3V3 and MGTAVCC rails
    [K410T-devboard.kicad_pcb, K410T-devboard.kicad_sch, fpga-config.kicad_sch, fpga-supply.kicad_sch, power-supply.kicad_sch, spi-flash.kicad_sch]
2022-12-23 Add SD-CARD bus. Add user SPI flash, rename main SPI flash bus. Add uSD card slot
    [K410T-devboard.kicad_sch, spi-flash.kicad_sch]
2022-12-23 Change bus entry size to 1.27mm for better readability
    [fpga-banks-12-15.kicad_sch, fpga-banks-33-34.kicad_sch, ram.kicad_sch, spi-flash.kicad_sch]
2022-12-23 Connect SD_CARD and USR_FLASH_0 to FPGA
    [K410T-devboard.kicad_sch]
2022-12-23 Update system SPI Flash bus name, rearrange sheets
    [K410T-devboard.kicad_sch, fpga-banks-12-15.kicad_sch, fpga-config.kicad_sch]
2022-12-23 Connect user SPI Flash to FPGA
    [fpga-banks-16-32.kicad_sch]
2022-12-23 Unify sheets tables, add user-gpio sheet
    [K410T-devboard.kicad_sch, power-supply.kicad_sch, spi-flash.kicad_sch, user-gpio.kicad_sch]
2022-12-23 Change uSD capacitor to 1uF
    [spi-flash.kicad_sch]
2022-12-23 Add PMOD connectors, leave place for leds, buttons and dip switches
    [K410T-devboard.kicad_sch, user-gpio.kicad_sch]
2022-12-27 Replace resistor ladder with 0402 resistors
    [ram.kicad_sch]
2022-12-27 Add USB host controller with SPI interface
    [K410T-devboard.kicad_sch, usb-phy.kicad_sch, user-gpio.kicad_sch]
2022-12-27 Add TUSB1106 USB xceiver, update bus definitions
    [K410T-devboard.kicad_sch, usb-phy.kicad_sch]
2022-12-27 Add HDMI/Ethernet sheet
    [K410T-devboard.kicad_sch, hdmi-ethernet.kicad_sch, usb-phy.kicad_sch]
2022-12-27 Add ETH PHY
    [K410T-devboard.kicad_sch, hdmi-ethernet.kicad_sch]
2022-12-27 Add HDMI connector
    [K410T-devboard.kicad_sch, hdmi-ethernet.kicad_sch]
2022-12-27 Unify reference designator placement
    [hdmi-ethernet.kicad_sch, ram.kicad_sch, spi-flash.kicad_sch, usb-phy.kicad_sch]
2022-12-27 Add bootstrap resistors to ETH PHY IC
    [K410T-devboard.kicad_sch, hdmi-ethernet.kicad_sch]
2022-12-27 Add todo to HDMI
    [hdmi-ethernet.kicad_sch]
2022-12-27 Add DDR3L VTT termination regulator
    [power-supply.kicad_sch]
2022-12-27 Add 1V0 DC-DC, VCCADC and VREFP reference voltages, input jack with reverse polarity protection
    [fpga-config.kicad_sch, fpga-supply.kicad_sch, power-supply.kicad_sch]
2022-12-27 Add RMII bus definition
    [K410T-devboard.kicad_sch]
2022-12-27 Add RMII ETH PHY
    [hdmi-ethernet.kicad_sch]
2022-12-27 Replace labels with power symbols
    [power-supply.kicad_sch]
2022-12-27 Add FMC+ HSPC sheet
    [fmc-hspc.kicad_sch]
2022-12-28 Add missing labels on ISET and internal power rails. Update GBE bootstrap config info
    [hdmi-ethernet.kicad_sch]
2022-12-28 Add leds, buttons and dip-switch
    [K410T-devboard.kicad_sch, user-gpio.kicad_sch]
2022-12-28 Replaced 3V3 DC-DC with secondd MPM54304GMN, add power supply sequencing, add compatibility with CW310 signalling, add MGTAVTT LDO, add flexible FB options
    [power-supply.kicad_sch]
2022-12-28 Add missing DCT 0R, connect 3.3V rail to LAN8720A
    [hdmi-ethernet.kicad_sch]
2022-12-28 Add RST signal to JTAG bus
    [K410T-devboard.kicad_sch]
2022-12-28 Add FTDI to USB-PHY subsheet
    [usb-phy.kicad_sch]
2022-12-28 Add USB PD
    [K410T-devboard.kicad_sch, usb-phy.kicad_sch]
2022-12-28 Minor readability improvement. Add power flags in USB and ETH sheets
    [K410T-devboard.kicad_sch, hdmi-ethernet.kicad_sch, usb-phy.kicad_sch]
2022-12-28 Fix 1V8 DC-DC feedback, re-add FMC+ connector sheet
    [K410T-devboard.kicad_sch, fmc-hspc.kicad_sch, power-supply.kicad_sch]
2022-12-28 Fix PoE labels in hdmi-ethernet sheet
    [hdmi-ethernet.kicad_sch]
2022-12-28 Fill title block in fmc-hspc sheet
    [fmc-hspc.kicad_sch]
2022-12-28 Move DC/DC to separate sheet. Add PoE, move USB-C PD to power-supply
    [K410T-devboard.kicad_sch, dc-dc.kicad_sch, power-supply.kicad_sch, usb-phy.kicad_sch]
2022-12-29 Add MGTX bus class and add labels to GTX banks
    [K410T-devboard.kicad_sch, fpga-mgt.kicad_sch]
2022-12-29 Add power supply OR'ing, replace VIN global label with power symbol
    [K410T-devboard.kicad_sch, dc-dc.kicad_sch, power-supply.kicad_sch]
2022-12-29 Add VTT, VREF power buses to RAM
    [K410T-devboard.kicad_sch, ram.kicad_sch]
2022-12-29 Change +0V675_VTT label to proper power symbol
    [fpga-banks-33-34.kicad_sch]
2022-12-29 Connect PMODs to bank13
    [fpga-banks-12-15.kicad_sch]
2022-12-29 Update DDR connection to FPGA
    [fpga-banks-33-34.kicad_sch]
2022-12-29 Update system flash bus unfolded labels
    [fpga-banks-12-15.kicad_sch, fpga-config.kicad_sch, spi-flash.kicad_sch]
2022-12-29 Connect user USB to FPGA. Connect RMII, usr USB and usr SPI Flash 1 on root sheet
    [K410T-devboard.kicad_sch, fpga-banks-16-32.kicad_sch, usb-phy.kicad_sch]
2022-12-29 Add pushbutton ON/OFF controller, tidy up dc-dc sheet
    [dc-dc.kicad_sch]
2022-12-29 Connect LED, DIP switch and buttons to FPGA
    [K410T-devboard.kicad_sch, fpga-banks-12-15.kicad_sch, fpga-banks-33-34.kicad_sch, user-gpio.kicad_sch]
2022-12-29 Add FMC+ HPSC connector
    [fmc-hspc.kicad_sch]
2022-12-29 Update VTT labels with power symbols on DC-DC sheet
    [dc-dc.kicad_sch]
2022-12-29 Remap FMC+ signals to GTX buses
    [fmc-hspc.kicad_sch]
2022-12-29 Replace 5V_ALWAYS_ON label with +5V_AON power symbol
    [K410T-devboard.kicad_sch, dc-dc.kicad_sch]
2022-12-29 Connect user buttons and dip switch pullups to 1.8V
    [K410T-devboard.kicad_sch, user-gpio.kicad_sch]
2022-12-29 Add missing +0V675_VTT power symbol to DDR termination
    [K410T-devboard.kicad_sch, ram.kicad_sch]
2022-12-29 Connect 1V8 power label to RMII controller
    [K410T-devboard.kicad_sch, hdmi-ethernet.kicad_sch]
2022-12-29 Connect 1V8 to usr USB VCIO and pullups
    [K410T-devboard.kicad_sch, usb-phy.kicad_sch]
2022-12-30 Connect MGT supplies, fix FMC+ connector, export components to PCB
    [K410T-devboard.kicad_pcb, K410T-devboard.kicad_sch, dc-dc.kicad_sch, fmc-hspc.kicad_sch, fpga-banks-33-34.kicad_sch, fpga-config.kicad_sch, fpga-mgt.kicad_sch, fpga-supply.kicad_sch]
2022-12-30 Change MGT labels to hierarhical
    [K410T-devboard.kicad_sch, fmc-hspc.kicad_sch, fpga-mgt.kicad_sch]
2022-12-30 Add CW-20PIN connector and connect it to FPGA
    [K410T-devboard.kicad_sch, fpga-banks-12-15.kicad_sch, user-gpio.kicad_sch]
2022-12-30 Add clock generation sheet, create main system clock and PLL circuit
    [clocks.kicad_sch]
2022-12-30 Add clocks schematic to the main sheet
    [K410T-devboard.kicad_sch]
2022-12-30 Add diode temp sensor
    [K410T-devboard.kicad_sch, clocks.kicad_sch, fpga-config.kicad_sch, user-gpio.kicad_sch]
2023-01-02 Update project structure in root schematic
    [K410T-devboard.kicad_sch, clocks.kicad_sch, dc-dc.kicad_sch, fmc-hspc.kicad_sch, fpga-bank-12.kicad_sch, fpga-bank-13.kicad_sch, fpga-bank-14.kicad_sch, fpga-bank-15.kicad_sch]
2023-01-02 Change power labels from global to proper power labels
    [K410T-devboard.kicad_sch, dc-dc.kicad_sch, fpga-supply.kicad_sch]
2023-01-02 Group FMC+ related subsheets close together
    [K410T-devboard.kicad_sch]
2023-01-02 Add 40pin and 34pin gpio headers, connect them to FPGA
    [K410T-devboard.kicad_sch, fpga-bank-15.kicad_sch, fpga-bank-16.kicad_sch, user-gpio.kicad_sch]
2023-01-02 Improve readability of bus connections to FPGA
    [fpga-bank-12.kicad_sch, fpga-bank-13.kicad_sch, fpga-bank-32.kicad_sch, fpga-bank-33.kicad_sch]
2023-01-02 Connect RGMII and HDMI to FPGA
    [K410T-devboard.kicad_sch, fpga-bank-17.kicad_sch]
2023-01-02 Add clocks bus assigment, FTDI buffering WiP
    [K410T-devboard.kicad_sch, clocks.kicad_sch, fpga-config.kicad_sch, usb-phy.kicad_sch, user-gpio.kicad_sch]
2023-01-02 Finish FTDI buffering
    [K410T-devboard.kicad_sch, clocks.kicad_sch, fpga-config.kicad_sch, usb-phy.kicad_sch, user-gpio.kicad_sch]
2023-01-03 Change FTDI-I2C/SPI labels to bidirectional
    [usb-phy.kicad_sch]
2023-01-03 Update hierarchical labels from USB-PHY subsheet
    [K410T-devboard.kicad_sch]
2023-01-03 Connect power rails to GBE
    [K410T-devboard.kicad_sch, hdmi-ethernet.kicad_sch]
2023-01-03 Connect 5V to HDMI connector
    [K410T-devboard.kicad_sch, clocks.kicad_sch, hdmi-ethernet.kicad_sch]
2023-01-03 Align resistors reference designators
    [hdmi-ethernet.kicad_sch]
2023-01-03 Improve designators/values placement
    [power-supply.kicad_sch]
2023-01-03 Add FTDI buffers decoupling
    [K410T-devboard.kicad_sch, usb-phy.kicad_sch]
2023-01-03 Unify designators orientation
    [ram.kicad_sch]
2023-01-03 Connect 1V8 to SPI flash 0
    [K410T-devboard.kicad_sch, spi-flash.kicad_sch]
2023-01-03 Change LVDS_XO_200M_ENA to global label. Import labels from clock subsheet
    [K410T-devboard.kicad_sch, clocks.kicad_sch]
2023-01-03 Add R0 to FTDI I2C singals behind buffer
    [fpga-config.kicad_sch, usb-phy.kicad_sch]
2023-01-03 Fix FPGA symbol
    [K410T-devboard.kicad_sch, clocks.kicad_sch, dc-dc.kicad_sch, fpga-bank-12.kicad_sch, fpga-bank-13.kicad_sch, fpga-bank-14.kicad_sch, fpga-bank-15.kicad_sch, fpga-bank-16.kicad_sch]
2023-01-03 Connect USB_HOST SPI interface to FPGA
    [fpga-bank-17.kicad_sch]
2023-01-03 Connect I2C bus
    [K410T-devboard.kicad_sch, clocks.kicad_sch, dc-dc.kicad_sch, fpga-bank-13.kicad_sch, fpga-bank-33.kicad_sch, fpga-config.kicad_sch, power-supply.kicad_sch]
2023-01-03 Connect SPI bus
    [K410T-devboard.kicad_sch, clocks.kicad_sch, dc-dc.kicad_sch, fpga-bank-14.kicad_sch]
2023-01-03 Fix SPI flash signal labels
    [spi-flash.kicad_sch]
2023-01-03 Change I2C spelling to superscript
    [K410T-devboard.kicad_sch, clocks.kicad_sch, dc-dc.kicad_sch, fpga-config.kicad_sch, power-supply.kicad_sch, usb-phy.kicad_sch]
2023-01-03 Connect IO bank 15 and MGT bank 115 and 116 to FMC+
    [K410T-devboard.kicad_sch, fmc-hspc.kicad_sch, fpga-bank-18.kicad_sch]
2023-01-03 Fix system-flash connection to FPGA
    [fpga-bank-14.kicad_sch]
2023-01-03 Connect USB_HOST on root schematic
    [K410T-devboard.kicad_sch, clocks.kicad_sch, fpga-bank-13.kicad_sch, fpga-bank-14.kicad_sch, usb-phy.kicad_sch]
2023-01-03 Add fan headers
    [K410T-devboard.kicad_sch, clocks.kicad_sch, fpga-bank-14.kicad_sch, fpga-bank-32.kicad_sch, user-gpio.kicad_sch]
2023-01-03 Re-annotate the schematic. Export changes to PCB
    [K410T-devboard.kicad_pcb, K410T-devboard.kicad_sch, clocks.kicad_sch, dc-dc.kicad_sch, fmc-hspc.kicad_sch, fpga-bank-14.kicad_sch, fpga-bank-34.kicad_sch, fpga-config.kicad_sch]
2023-01-03 Start creating PCB technology mock
    [K410T-devboard.kicad_pcb]
2023-01-03 Fix power pins on symbols. Add power selection to bank 15 and 16
    [K410T-devboard.kicad_sch, clocks.kicad_sch, dc-dc.kicad_sch, fpga-supply.kicad_sch, hdmi-ethernet.kicad_sch, power-supply.kicad_sch, ram.kicad_sch, spi-flash.kicad_sch]
2023-01-04 Connect FPGA bank 17 and 18 to 3.3V
    [fpga-supply.kicad_sch]
2023-01-04 Add VCC_USC_A/B labels, apply them to GPIO, FPGA power and SPI Flash
    [K410T-devboard.kicad_sch, clocks.kicad_sch, fpga-supply.kicad_sch, spi-flash.kicad_sch, user-gpio.kicad_sch]
2023-01-04 Add supervisor MCU subsheet and connectors
    [K410T-devboard.kicad_sch, supervisor-mcu.kicad_sch]
2023-01-04 Fix MGAVTT label
    [K410T-devboard.kicad_sch, dc-dc.kicad_sch, fpga-supply.kicad_sch]
2023-01-04 Create FPGA power supply planes
2023-01-04 Annotate new parts, sync schematic and PCB
    [K410T-devboard.kicad_sch, clocks.kicad_sch, dc-dc.kicad_sch, fpga-supply.kicad_sch, spi-flash.kicad_sch, supervisor-mcu.kicad_sch, user-gpio.kicad_sch]
2023-01-04 Update MPM54304GMN symbol FB3 pin type
    [K410T-devboard.kicad_sch, dc-dc.kicad_sch]
2023-01-04 Change supervisor-mcu sheet size. Update dates
    [K410T-devboard.kicad_sch, clocks.kicad_sch, dc-dc.kicad_sch, fmc-hspc.kicad_sch, fpga-bank-12.kicad_sch, fpga-bank-13.kicad_sch, fpga-bank-14.kicad_sch, fpga-bank-15.kicad_sch]
2023-01-04 Finish placing the decoulplig under FPGA, adjust power planes, color voltage domains
    [K410T-devboard.kicad_sch, fpga-supply.kicad_sch]
2023-01-04 Replace BRAM 4u7 caps to 0201, optimize decoupling placement
    [K410T-devboard.kicad_sch, clocks.kicad_sch, fpga-supply.kicad_sch]
2023-01-04 Update supervisor MCU connectors, apply pinout to connectors
    [K410T-devboard.kicad_sch, supervisor-mcu.kicad_sch]
2023-01-05 Update pinout for MCU connectors, extend SUP-MCU bus def
    [K410T-devboard.kicad_sch, supervisor-mcu.kicad_sch]
2023-01-05 Replace 3D model for 0201 capacitors, Add decoupling capacitors for MGT transcivers, flip MGT fanout, finish decoupling
    [K410T-devboard.kicad_sch, clocks.kicad_sch, fpga-supply.kicad_sch, supervisor-mcu.kicad_sch]
2023-01-05 Add new pinout to sup MCU. Start connecting it to FPGA
    [K410T-devboard.kicad_sch, clocks.kicad_sch, dc-dc.kicad_sch, fpga-bank-12.kicad_sch, fpga-bank-13.kicad_sch, fpga-bank-14.kicad_sch, fpga-config.kicad_sch]
2023-01-05 DDR3L routing try-on WiP
    [K410T-devboard.kicad_sch, clocks.kicad_sch, supervisor-mcu.kicad_sch]
2023-01-09 Add DDR3L decoupling capacitors
    [K410T-devboard.kicad_sch, clocks.kicad_sch, dc-dc.kicad_sch, fpga-bank-12.kicad_sch, fpga-bank-14.kicad_sch, fpga-config.kicad_sch, ram.kicad_sch, supervisor-mcu.kicad_sch]
2023-01-09 Update pinout of the sup MCU connectors
    [supervisor-mcu.kicad_sch]
2023-01-09 Add system flash DQ2/3 note
    [spi-flash.kicad_sch]
2023-01-09 Add SUP MCU controll over USB-C PD RST signal
    [power-supply.kicad_sch]
2023-01-09 Add SUP MCU controll over FAN PWM
    [user-gpio.kicad_sch]
2023-01-09 Connect SUP MCU CLCK signal to FPGA
    [fpga-config.kicad_sch]
2023-01-09 Add to-do to dc-dc sheet
    [dc-dc.kicad_sch]
2023-01-09 Connect MCU CFG_CS signal to system FLASH CS signal
    [fpga-bank-14.kicad_sch]
2023-01-09 Final placement for DDR3L, Termination pre-routing, add DQ/DQS 40Ohm custom rules
2023-01-09 Fix DDR3L placement
    [K410T-devboard.kicad_sch, clocks.kicad_sch, fpga-bank-14.kicad_sch, fpga-config.kicad_sch, power-supply.kicad_sch, ram.kicad_sch, supervisor-mcu.kicad_sch, user-gpio.kicad_sch]
2023-01-09 Increase DDR3L termination track width
2023-01-09 Fix libraries, sync schematic with PCB
    [power-supply.kicad_sch, supervisor-mcu.kicad_sch, usb-phy.kicad_sch]
2023-01-09 Power supply placement WiP
2023-01-09 Fix 1V0 DC-DC label
    [dc-dc.kicad_sch]
2023-01-10 Finish connecting MCU
    [K410T-devboard.kicad_sch, clocks.kicad_sch, dc-dc.kicad_sch, fpga-config.kicad_sch, supervisor-mcu.kicad_sch]
2023-01-10 Improve RAM sheet
    [K410T-devboard.kicad_sch, ram.kicad_sch]
2023-01-10 Connect TEMP_ALERT_N signal to MCU
    [K410T-devboard.kicad_sch, fpga-config.kicad_sch, supervisor-mcu.kicad_sch]
2023-01-10 Replace two ethernet porst with one dual port
    [K410T-devboard.kicad_sch, hdmi-ethernet.kicad_sch]
2023-01-10 Replace HDMI connector with vertical one
    [K410T-devboard.kicad_sch, hdmi-ethernet.kicad_sch]
2023-01-10 Replace USB-C connectors with vertical ones
    [K410T-devboard.kicad_sch, usb-phy.kicad_sch]
2023-01-10 Replace CW connector with 1.27m pitch
    [K410T-devboard.kicad_sch, user-gpio.kicad_sch]
2023-01-10 Replace SM04B connectors with BM04B
    [K410T-devboard.kicad_sch, user-gpio.kicad_sch]
2023-01-10 Fix libs, sync schematic with PCB
    [K410T-devboard.kicad_sch, clocks.kicad_sch, dc-dc.kicad_sch, fpga-config.kicad_sch, hdmi-ethernet.kicad_sch, ram.kicad_sch, supervisor-mcu.kicad_sch, usb-phy.kicad_sch]
2023-01-10 Fix missconnected ETH_LED_LINK- label
    [K410T-devboard.kicad_sch, clocks.kicad_sch, hdmi-ethernet.kicad_sch, user-gpio.kicad_sch]
2023-01-10 DC-DC sheet grouping and placement on PCB
    [dc-dc.kicad_sch]
2023-01-10 Unify used buttons
    [dc-dc.kicad_sch, fpga-config.kicad_sch]
2023-01-10 Change PMOD connectors to sockets
    [user-gpio.kicad_sch]
2023-01-10 Inital connectors placement
    [K410T-devboard.kicad_sch]
2023-01-10 Move DC-IN related components close to connector
2023-01-10 Finish DC/DC and PoE placement, connect DDR3L VRP and VRL, remove PoE disable optocoupler
    [K410T-devboard.kicad_sch, clocks.kicad_sch, hdmi-ethernet.kicad_sch, power-supply.kicad_sch]
2023-01-10 Manually import changes from pcb-wip branch
    [K410T-devboard.kicad_sch, clocks.kicad_sch, hdmi-ethernet.kicad_sch, power-supply.kicad_sch, usb-phy.kicad_sch]
2023-01-11 Add Antmicro and OSHW logo, date and revision on PCB
2023-01-11 Add FPGA radiator, setup layer stack
    [K410T-devboard.kicad_sch, clocks.kicad_sch, hdmi-ethernet.kicad_sch]
2023-01-11 Fix JTAG buffor mixed labels
    [usb-phy.kicad_sch]
2023-01-11 Replace 100n to 0402
    [K410T-devboard.kicad_sch, clocks.kicad_sch, fmc-hspc.kicad_sch, fpga-bank-34.kicad_sch, fpga-supply.kicad_sch, hdmi-ethernet.kicad_sch, ram.kicad_sch, usb-phy.kicad_sch]
2023-01-11 Increase 0201 to 0402 components where possible (EIA 0402 footprint)
    [K410T-devboard.kicad_sch, clocks.kicad_sch, dc-dc.kicad_sch, fpga-bank-34.kicad_sch, fpga-config.kicad_sch, fpga-supply.kicad_sch, ram.kicad_sch]
2023-01-11 Change SRAM to BGA
    [K410T-devboard.kicad_sch, clocks.kicad_sch, hdmi-ethernet.kicad_sch, ram.kicad_sch]
2023-01-11 Change DDR3L decoupling capacitors to 0402, channg SRAM termiantion to resistor array
    [K410T-devboard.kicad_sch, ram.kicad_sch]
2023-01-12 Add second 0Ohm for VCORE, placement for PD ideal diode
    [K410T-devboard.kicad_sch, clocks.kicad_sch, dc-dc.kicad_sch, hdmi-ethernet.kicad_sch]
2023-01-12 Fix minor label missmatch. Continue placment
    [K410T-devboard.kicad_sch, clocks.kicad_sch, hdmi-ethernet.kicad_sch, supervisor-mcu.kicad_sch, usb-phy.kicad_sch]
2023-01-12 Fix labels missmatch. Finish component grouping
    [K410T-devboard.kicad_sch, clocks.kicad_sch, hdmi-ethernet.kicad_sch, user-gpio.kicad_sch]
2023-01-13 Change ULS-12/5-D48N-C to ULS-12/8.3-D48N-C
    [power-supply.kicad_sch]
2023-01-13 Change uSD card holder to DM3AT-SF-PEJM5
    [spi-flash.kicad_sch]
2023-01-13 Import recent changes to PCB
    [K410T-devboard.kicad_sch]
2023-01-13 Implemented fixes after schematic review
    [K410T-devboard.kicad_sch, clocks.kicad_sch, dc-dc.kicad_sch, hdmi-ethernet.kicad_sch, power-supply.kicad_sch, spi-flash.kicad_sch, usb-phy.kicad_sch]
2023-01-13 Added 100n + 100R on SD card shield
    [K410T-devboard.kicad_sch, spi-flash.kicad_sch]
2023-01-13 Place all components inside PCB outline
2023-01-13 Connected DQ2 DQ3 lines of SPI flash to FPGA bank 14
    [K410T-devboard.kicad_sch, clocks.kicad_sch, fpga-bank-14.kicad_sch, hdmi-ethernet.kicad_sch, spi-flash.kicad_sch]
2023-01-16 Import changes to PCB. Align part of the designators
    [K410T-devboard.kicad_sch, clocks.kicad_sch, dc-dc.kicad_sch, hdmi-ethernet.kicad_sch, power-supply.kicad_sch, spi-flash.kicad_sch, usb-phy.kicad_sch]
2023-01-16 Improve placement of the GBE and USB Host PHY. Update pinout for better routing
    [K410T-devboard.kicad_sch, fpga-bank-13.kicad_sch, fpga-bank-17.kicad_sch, hdmi-ethernet.kicad_sch, usb-phy.kicad_sch]
2023-01-16 Changed +5V_AON to +3V3_AON and LDO to 3.3V variant
    [K410T-devboard.kicad_sch, clocks.kicad_sch, dc-dc.kicad_sch, hdmi-ethernet.kicad_sch]
2023-01-16 Connected PB_CTRL_OUT and PB_CTRL_INT signals to FPGA
    [K410T-devboard.kicad_sch, clocks.kicad_sch, dc-dc.kicad_sch, fpga-bank-13.kicad_sch, power-supply.kicad_sch]
2023-01-16 Added USB power switches on USB HOST and USB USR
    [K410T-devboard.kicad_sch, usb-phy.kicad_sch]
2023-01-16 Connected USB PON and DET signals to FPGA
    [K410T-devboard.kicad_sch, clocks.kicad_sch, dc-dc.kicad_sch, fpga-bank-13.kicad_sch, usb-phy.kicad_sch]
2023-01-16 Removed ToDo notes which are already done, corrected USB DET and PEN signal mapping on FPGA side, connected 200MHz generator ENA signal to FPGA
    [K410T-devboard.kicad_sch, clocks.kicad_sch, fpga-bank-13.kicad_sch, fpga-bank-33.kicad_sch, hdmi-ethernet.kicad_sch, spi-flash.kicad_sch, usb-phy.kicad_sch]
2023-01-16 Removed doubled 10uF on USR_USB VBUS
    [K410T-devboard.kicad_sch, usb-phy.kicad_sch]
2023-01-16 Annotated designators for new components
    [K410T-devboard.kicad_sch, clocks.kicad_sch, dc-dc.kicad_sch, hdmi-ethernet.kicad_sch, usb-phy.kicad_sch]
2023-01-16 Added PWM fan control signal to FPGA, finished routing of USB PD group, temp sensor and user spi flash 0
    [K410T-devboard.kicad_sch, clocks.kicad_sch, fpga-bank-13.kicad_sch, hdmi-ethernet.kicad_sch, user-gpio.kicad_sch]
2023-01-16 E-fuse placement on PCB
2023-01-16 Divide USR IO track between two layers. Route CW20 header. Improve low-speed layer utilization
2023-01-17 Finished routing of SPI flash chips
2023-01-17 Routing DRAM, modified signal mapping on termination resistor ladders
    [K410T-devboard.kicad_sch, clocks.kicad_sch, hdmi-ethernet.kicad_sch, ram.kicad_sch]
2023-01-17 Add connection for MGT bank 117 and 118 to FMC+
    [K410T-devboard.kicad_sch, fmc-hspc.kicad_sch]
2023-01-17 Place components inside PCB outline
2023-01-17 Dix GTX signals connected to GND
    [fmc-hspc.kicad_sch]
2023-01-17 Add FMC+ to do's
    [fmc-hspc.kicad_sch]
2023-01-18 Updated layour from schematic
2023-01-18 Recalculated length matching of DRAM DQ signals including pad to die distances
2023-01-20 Sync PCB with schematics, add vias to SRAM
2023-01-20 PCIe routing - checking for signal crossings
    [K410T-devboard.kicad_sch, clocks.kicad_sch, fmc-hspc.kicad_sch, hdmi-ethernet.kicad_sch]
2023-01-20 Import low-speed signal routing from pcb-wip
2023-01-20 Fixes on schematic, aligned bank 13 to grid
    [K410T-devboard.kicad_sch, clocks.kicad_sch, hdmi-ethernet.kicad_sch]
2023-01-20 Determined signal paths for PCIe, swapped GTX115.TX signals from 0-1-2-3 to 2-1-3-0, swapped signals on layers between GTX116.TX3 and GTX116.REFCLK0
    [fmc-hspc.kicad_sch, fpga-mgt.kicad_sch]
2023-01-20 Swapped order of GTX116.RX3 with GTX116.RX1
    [fpga-mgt.kicad_sch]
2023-01-20 Update ETH connector footprint
2023-01-20 Working on final fixes on PCIe interface signals
    [K410T-devboard.kicad_sch, clocks.kicad_sch, fmc-hspc.kicad_sch, hdmi-ethernet.kicad_sch]
2023-01-20 Provided FMC signals on FPGA outline
    [K410T-devboard.kicad_sch, clocks.kicad_sch, hdmi-ethernet.kicad_sch]
2023-01-20 Provided feedpoints for FCM 90ohm diff pairs on FPGA edge
2023-01-20 Update signage
    [K410T-devboard.kicad_sch, clocks.kicad_sch, dc-dc.kicad_sch, fmc-hspc.kicad_sch, fpga-bank-12.kicad_sch, fpga-bank-13.kicad_sch, fpga-bank-14.kicad_sch, fpga-bank-15.kicad_sch]
2023-01-23 Finished FMC signals routing
    [K410T-devboard.kicad_sch, clocks.kicad_sch, dc-dc.kicad_sch, fmc-hspc.kicad_sch, fpga-bank-12.kicad_sch, fpga-bank-13.kicad_sch, fpga-bank-14.kicad_sch, fpga-bank-15.kicad_sch]
2023-01-23 Update SRAM termination resistor array connections
    [K410T-devboard.kicad_sch, clocks.kicad_sch, hdmi-ethernet.kicad_sch, ram.kicad_sch]
2023-01-23 Fix signal mix on FTDI-JTAG buffer. Route half of the SUP MCU traces
    [usb-phy.kicad_sch]
2023-01-23 Add missing GND connections
    [fmc-hspc.kicad_sch]
2023-01-23 Add missing GND connection to FMC L row
    [fmc-hspc.kicad_sch]
2023-01-23 Sync changes from chematics to PCB
2023-01-23 Connect FMC GND
2023-01-24 Reconnect SPI Flash 0 and RMII
2023-01-24 Finished routing SPI flash chips
2023-01-24 Route GBE, USR USB, SPI to FTDI
2023-01-24 Started layout of DC-DC converter power planes
2023-01-24 Swap GBE pairs for easier routing
    [hdmi-ethernet.kicad_sch]
2023-01-24 Import updated NCP451AFCT2G symbol
    [dc-dc.kicad_sch]
2023-01-24 Routed U37 and In2.CU power plane
2023-01-24 Connecting GND on FMC connectors - in progress; added changes on In2 layer
2023-01-24 Finished grounding of FMC connector
2023-01-25 Remove TODO, update HDMI ESD connections based on routing
    [hdmi-ethernet.kicad_sch]
2023-01-25 Connect FMC 12V diode to VDC instead of VIN
    [fmc-hspc.kicad_sch]
2023-01-25 Fix 100n value position
    [K410T-devboard.kicad_sch, clocks.kicad_sch, fmc-hspc.kicad_sch, fpga-bank-34.kicad_sch, fpga-supply.kicad_sch, hdmi-ethernet.kicad_sch, ram.kicad_sch, usb-phy.kicad_sch]
2023-01-25 Make USB e-fuses circuitry more readable. Fix GND via intersecting signal trace
    [usb-phy.kicad_sch]
2023-01-25 Routed power traces and planes
2023-01-25 Improved power routing
2023-01-25 Corrected schematic according to review
    [K410T-devboard.kicad_sch, clocks.kicad_sch, dc-dc.kicad_sch, fpga-bank-15.kicad_sch, hdmi-ethernet.kicad_sch, usb-phy.kicad_sch, user-gpio.kicad_sch]
2023-01-25 Corrected schematic, changed DRAM pullup array value, removed PWM signal from botton FAN connector
    [K410T-devboard.kicad_sch, clocks.kicad_sch, hdmi-ethernet.kicad_sch, ram.kicad_sch, user-gpio.kicad_sch]
2023-01-25 Finished implementing all changes from sch review
    [K410T-devboard.kicad_sch, clocks.kicad_sch, dc-dc.kicad_sch, fpga-bank-14.kicad_sch, power-supply.kicad_sch, spi-flash.kicad_sch, usb-phy.kicad_sch, user-gpio.kicad_sch]
2023-01-25 Updated annotation
    [K410T-devboard.kicad_sch, clocks.kicad_sch, dc-dc.kicad_sch, fmc-hspc.kicad_sch, hdmi-ethernet.kicad_sch, power-supply.kicad_sch, ram.kicad_sch, usb-phy.kicad_sch]
2023-01-25 Routed more low speed signals
    [K410T-devboard.kicad_sch, clocks.kicad_sch, hdmi-ethernet.kicad_sch]
2023-01-25 Copied changes from pcb-tb branch
2023-01-25 Low speed routing
    [K410T-devboard.kicad_sch, clocks.kicad_sch, dc-dc.kicad_sch, fpga-supply.kicad_sch, hdmi-ethernet.kicad_sch, ram.kicad_sch]
2023-01-26 Updated PCB from schematic
2023-01-26 Misc signal routing, added input fuse
    [K410T-devboard.kicad_sch, hdmi-ethernet.kicad_sch, power-supply.kicad_sch, spi-flash.kicad_sch]
2023-01-26 Routed power input planes
2023-01-26 Routed regulators left of DDR RAM
2023-01-27 MAdded changes on DDR3L - signals length matching finished
    [K410T-devboard.kicad_sch, clocks.kicad_sch, hdmi-ethernet.kicad_sch]
2023-01-27 Completed routing of all signals; Fixed FPGA DDR reference
    [K410T-devboard.kicad_sch, clocks.kicad_sch, fpga-bank-34.kicad_sch, fpga-config.kicad_sch, hdmi-ethernet.kicad_sch]
2023-01-27 Fixed USB PEN signals
    [K410T-devboard.kicad_sch, fpga-bank-34.kicad_sch, hdmi-ethernet.kicad_sch, usb-phy.kicad_sch]
2023-01-27 Schematic cleanup
    [K410T-devboard.kicad_sch, clocks.kicad_sch, dc-dc.kicad_sch, fmc-hspc.kicad_sch, fpga-bank-13.kicad_sch, fpga-bank-14.kicad_sch, fpga-bank-15.kicad_sch, fpga-bank-16.kicad_sch]
2023-01-27 Added control signals on FMC connector
    [K410T-devboard.kicad_sch, fmc-hspc.kicad_sch, fpga-bank-13.kicad_sch, fpga-bank-15.kicad_sch, fpga-bank-16.kicad_sch, fpga-bank-17.kicad_sch, fpga-bank-32.kicad_sch, fpga-bank-33.kicad_sch]
2023-01-27 Synced PCB with schematic
2023-01-27 Updated schematic page fields
    [K410T-devboard.kicad_sch, clocks.kicad_sch, dc-dc.kicad_sch, fmc-hspc.kicad_sch, fpga-bank-12.kicad_sch, fpga-bank-13.kicad_sch, fpga-bank-14.kicad_sch, fpga-bank-15.kicad_sch]
2023-01-27 Adding JTAG to FMC connector - in progress
    [K410T-devboard.kicad_sch, clocks.kicad_sch, dc-dc.kicad_sch, fmc-hspc.kicad_sch, fpga-bank-12.kicad_sch, fpga-bank-13.kicad_sch, fpga-bank-14.kicad_sch, fpga-bank-15.kicad_sch]
2023-01-27 Updated bottom silkscreen
2023-01-27 Added JTAG signals on FMC connector in sch
    [K410T-devboard.kicad_sch, fpga-config.kicad_sch, usb-phy.kicad_sch]
2023-01-27 Wired JTAG RST level shifter
2023-01-27 Corrected JTAG label on fmc-hspc sch
    [K410T-devboard.kicad_sch, clocks.kicad_sch, fmc-hspc.kicad_sch, hdmi-ethernet.kicad_sch]
2023-01-27 Finished routing JTAG signals to FMC
    [K410T-devboard.kicad_sch, usb-phy.kicad_sch]
2023-01-27 Minor PCB fixes
    [K410T-devboard.kicad_sch, clocks.kicad_sch, fmc-hspc.kicad_sch, fpga-bank-13.kicad_sch, hdmi-ethernet.kicad_sch, usb-phy.kicad_sch]
2023-01-27 Started top silkscreen placement
2023-01-30 Small tweaks on silkscreen
2023-01-31 Small tweaks on top silkscreen
2023-01-31 Corrected PCB after checking gerbers on EC
2023-02-01 Fixed bottom silkscreen overlaps
2023-02-01 Updated local libraries
    [K410T-devboard.kicad_sch, clocks.kicad_sch, dc-dc.kicad_sch, fmc-hspc.kicad_sch, fpga-bank-12.kicad_sch, fpga-bank-13.kicad_sch, fpga-bank-14.kicad_sch, fpga-bank-15.kicad_sch]
2023-02-01 Marked DNP on PCB
2023-02-01 Bump revision to 1.0.0. Update name on schematic and PCB sheets
    [K410T-devboard.kicad_sch, clocks.kicad_sch, dc-dc.kicad_sch, fmc-hspc.kicad_sch, fpga-bank-12.kicad_sch, fpga-bank-13.kicad_sch, fpga-bank-14.kicad_sch, fpga-bank-15.kicad_sch]
2023-02-01 Changed placement of u.fl connector
2023-02-01 Cleaned unconnected traces
2023-02-01 Updated libraries for 100nF cap
    [K410T-devboard.kicad_sch, clocks.kicad_sch, fmc-hspc.kicad_sch, fpga-bank-34.kicad_sch, fpga-supply.kicad_sch, hdmi-ethernet.kicad_sch, ram.kicad_sch, usb-phy.kicad_sch]
2023-02-01 Changed U15 to NCP718
    [K410T-devboard.kicad_sch, usb-phy.kicad_sch]
2023-02-01 Updated library for symbol REF3012AIDBZT
    [dc-dc.kicad_sch]
2023-02-01 Remapped signals and added 0R - related to U33
    [K410T-devboard.kicad_sch, dc-dc.kicad_sch, fpga-bank-13.kicad_sch, hdmi-ethernet.kicad_sch, usb-phy.kicad_sch]
2023-10-18 Introduce component standardization
    [K410T-devboard.kicad_sch, clocks.kicad_sch, dc-dc.kicad_sch, fmc-hspc.kicad_sch, fpga-bank-12.kicad_sch, fpga-bank-13.kicad_sch, fpga-bank-14.kicad_sch, fpga-bank-15.kicad_sch]
2023-10-20 Add OHP assets
    [stackup.csv]
2023-10-26 [#50532] Update JST connectors footprints
    [K410T-devboard.kicad_sch, clocks.kicad_sch, dc-dc.kicad_sch, fmc-hspc.kicad_sch, fpga-bank-12.kicad_sch, fpga-bank-13.kicad_sch, fpga-bank-14.kicad_sch, fpga-bank-15.kicad_sch]
2024-02-27 [#55729] Fix DM3AT-SF-PEJM5
    Save project as KiCad 7
    [K410T-devboard.kicad_sch, clocks.kicad_sch, dc-dc.kicad_sch, fmc-hspc.kicad_sch, fpga-bank-12.kicad_sch, fpga-bank-13.kicad_sch, fpga-bank-14.kicad_sch, fpga-bank-15.kicad_sch]
2024-02-28 [#55729] Fix U_FL-R-SMT_10_
    [clocks.kicad_sch]
2024-02-28 [#55729] Update PCB from schemtatic
2024-02-29 [#55729] Fix microchip-ksz9131rnxc
    [hdmi-ethernet.kicad_sch]
2024-02-29 [#55729] Fix microchip-technology-lan8720a-cp-tr-abc
    [hdmi-ethernet.kicad_sch]
2024-03-01 [#55729] Fix micron-mt41k512m8da-107-xit-p-tr
    [ram.kicad_sch]
2024-03-01 [#55729] Fix batch of components Fix ftdi-ft4232h-56q-reel Fix maxim-integrated-max3421eetj Fix maxim-integrated-max16150aut-t Fix maxim-integrated-max1617amee-t Fix micron-mt25ql256aba1ew7-0sit
    [K410T-devboard.kicad_sch, clocks.kicad_sch, dc-dc.kicad_sch, fmc-hspc.kicad_sch, fpga-bank-12.kicad_sch, fpga-bank-13.kicad_sch, fpga-bank-14.kicad_sch, fpga-bank-15.kicad_sch]
2024-03-01 [#55729] Fix multicomp-mj-179ph
    [K410T-devboard.kicad_sch, clocks.kicad_sch, dc-dc.kicad_sch, fmc-hspc.kicad_sch, fpga-bank-12.kicad_sch, fpga-bank-13.kicad_sch, fpga-bank-14.kicad_sch, fpga-bank-15.kicad_sch]
2024-03-01 [#55729] Fix cnc-tech-2007435-1
    [hdmi-ethernet.kicad_sch]
2024-03-04 [#55729] Fix samtec-erf5-020-05-0-x-dv
    [supervisor-mcu.kicad_sch]
2024-03-04 [#55729] Change Manufacturer to AMD-Xilinx
    [fpga-bank-12.kicad_sch, fpga-bank-13.kicad_sch, fpga-bank-14.kicad_sch, fpga-bank-15.kicad_sch, fpga-bank-16.kicad_sch, fpga-bank-17.kicad_sch, fpga-bank-18.kicad_sch, fpga-bank-32.kicad_sch]
2024-03-04 [#55729] Run loclib
    [K410T-devboard.kicad_sch, clocks.kicad_sch, dc-dc.kicad_sch, fmc-hspc.kicad_sch, fpga-bank-12.kicad_sch, fpga-bank-13.kicad_sch, fpga-bank-14.kicad_sch, fpga-bank-15.kicad_sch]
2024-03-07 [#55729] Mark heatsink as DNP
    [K410T-devboard.kicad_sch]
2024-03-07 [#55729] Update pcb from schematic
2024-04-02 [#55729] Switch FPGA symbol to antmicroFPGAChips lib
    [K410T-devboard.kicad_sch, fpga-bank-12-13.kicad_sch, fpga-bank-13.kicad_sch, fpga-bank-14-15.kicad_sch, fpga-bank-15.kicad_sch, fpga-bank-16-17.kicad_sch, fpga-bank-17.kicad_sch, fpga-bank-18-32.kicad_sch]
2024-04-02 [#55729] Globlib; Clean DNP; Realign to grid
    [K410T-devboard.kicad_sch, clocks.kicad_sch, dc-dc.kicad_sch, fmc-hspc.kicad_sch, fpga-bank-12-13.kicad_sch, fpga-bank-14-15.kicad_sch, fpga-bank-16-17.kicad_sch, fpga-bank-18-32.kicad_sch]
2024-04-02 [#55729] Sch: clean power-supply, dc-dc
    [K410T-devboard.kicad_sch, dc-dc.kicad_sch, power-supply.kicad_sch]
2024-04-02 [#55729] Clean schematics/update from lib
    [clocks.kicad_sch, dc-dc.kicad_sch, fmc-hspc.kicad_sch, fpga-bank-12-13.kicad_sch, fpga-bank-14-15.kicad_sch, fpga-bank-16-17.kicad_sch, fpga-bank-18-32.kicad_sch, fpga-bank-33-34.kicad_sch]
2024-04-03 [#55729] Update PCB from sch; Update fp from lib; Clean DRC
    [clocks.kicad_sch, dc-dc.kicad_sch, fpga-bank-12-13.kicad_sch, fpga-bank-14-15.kicad_sch, fpga-config.kicad_sch, fpga-supply.kicad_sch, hdmi-ethernet.kicad_sch, power-supply.kicad_sch]
2024-04-03 [#55729] Optimize top-level schematic connections
    [K410T-devboard.kicad_sch]
2024-04-03 [#55729] Update date & revision
    [K410T-devboard.kicad_sch, clocks.kicad_sch, dc-dc.kicad_sch, fmc-hspc.kicad_sch, fpga-bank-12-13.kicad_sch, fpga-bank-14-15.kicad_sch, fpga-bank-16-17.kicad_sch, fpga-bank-18-32.kicad_sch]
2024-04-09 [#55729] Correct fp links to .step; clean DRC
    [K410T-devboard.kicad_sch, clocks.kicad_sch, dc-dc.kicad_sch, fmc-hspc.kicad_sch, fpga-bank-12-13.kicad_sch, fpga-bank-14-15.kicad_sch, fpga-bank-16-17.kicad_sch, fpga-bank-18-32.kicad_sch]
2024-06-05 [#58751] fix connector orientation
    [K410T-devboard.kicad_sch, clocks.kicad_sch, dc-dc.kicad_sch, fmc-hspc.kicad_sch, fpga-bank-12-13.kicad_sch, fpga-bank-14-15.kicad_sch, fpga-bank-16-17.kicad_sch, fpga-bank-18-32.kicad_sch]
2024-09-18 [#65778] Update kintex 410t blender model
    [fmc-hspc.kicad_sch]
2025-12-10 [#82975] Project refresh 81589
    [K410T-devboard.kicad_sch, clocks.kicad_sch, dc-dc.kicad_sch, fmc-hspc.kicad_sch, fpga-bank-12-13.kicad_sch, fpga-bank-14-15.kicad_sch, fpga-bank-16-17.kicad_sch, fpga-bank-18-32.kicad_sch]
2025-12-10 Fix project name, update README, cleanup files
    [K410T-devboard.kicad_sch, clocks.kicad_sch, dc-dc.kicad_sch, fmc-hspc.kicad_sch, fpga-bank-12-13.kicad_sch, fpga-bank-14-15.kicad_sch, fpga-bank-16-17.kicad_sch, fpga-bank-18-32.kicad_sch]
