antmicro/kintex-410t-devboard/(notices)

Notices in the files:
parts and their libraries:
License: Apache-2.0
License: MIT
